MrWANGXUHUI/niu-u1-foc-simulator/niu_u1_foc_simulator/README.md

# 小牛U1 FOC控制器模拟器

基于ESP32-C3的小牛U1电动车FOC电机控制器模拟器，实现损坏FOC控制器的功能替代，并添加霍尔轮速测速和OLED速度显示。

## 功能特性

- **FOC协议模拟** - 完整兼容小牛U1 485总线协议，响应V35中控轮询
- **霍尔轮速测量** - 实时测量轮速，OLED显示车速
- **电量统计** - 精确计算电池能耗(Wh/km)
- **原厂身份模拟** - 应答里带原厂 FOC 的 MU 编号 `MU00001B00000001`、版本串 `U1E02V11U1E02V11`，V35 校验通过
- **OTA 升级** - 开 WiFi 热点，微信小程序通过局域网 HTTP 把新固件直接推进来（不用拆线、不用按 BOOT）
- **BLE 遥测** - 车速/转速/电压/电流 + 总线上的 485 原始帧通过 GATT 推给小程序（看车速不用连 WiFi）
- **电池信息** - 解析总线上 BMS 的应答（电压/电流/电量/温度/单体电压/型号串），经 BLE 推给小程序

> 原计划的「BLE防丢器接近解锁」已放弃（红米手环广播窗口太短抓不稳，且iPhone无法配合），代码中已移除。
> NFC（PN532）无钥匙解锁方案也已于 2026-10-22 移除（驱动代码 / 接线文档 / 库依赖全部删除，I2C 只留板载 OLED）。

## 硬件清单

| 配件 | 型号/规格 | 数量 | 用途 |
|---|---|---|---|
| 主控 | 天问Pro TW002 (ESP32-C3-DevKitC-02) | 1 | 系统控制 |
| 通信 | MAX485模块(自动收发型) | 1 | RS485总线通信 |
| 轮速 | 霍尔传感器(SSR14Y/A3144) | 1 | 轮速测量 |
| 磁钢 | 单个磁铁（1 极） | 1 | 配合霍尔传感器 |
| 电源 | DC-DC降压模块 48V→5V | 1 | 供电 |

> 轮胎：**16x2.50/64-305**，实测转一圈 **1.28 米**（不是标称值）。
> 固件里对应 `MAGNET_COUNT = 1`、`WHEEL_CIRCUMFERENCE_M = 1.28`。

## 协议说明

### 485总线配置
- 波特率: **9600**
- 数据位: **8E1** (8数据位 + 偶校验 + 1停止位)
- 校验和: 从帧头累加到CS前一个字节，取低8位 (sum & 0xFF，**不是** CRC)
- 帧格式: `68 [地址] [地址反码] 68 [功能码] [字节数] [数据+0x33] [校验和] 16`

### 设备地址
| 设备 | 地址 | 备注 |
|---|---|---|
| FOC电机控制器 | 0x20 | 本模拟器 |
| 电池BMS | 0x31 | |
| 仪表 | 0x10 | |
| 中控 V35 ECU | 0x40 | 485 主节点 |

> **应答帧的地址对是「回话设备自己」**：真车抓包里 BMS 回 `31 CE`、仪表回 `10 EF`、FOC 回 `20 DF`。
> 所以本模拟器的应答固定用 `0x20 / 0xDF`（代码里 `REPLY_WITH_ECU_ADDR` 置 1 可改回 `0x40 / 0xBF`）。

### 关键命令
| 命令 | 说明 |
|---|---|
| 0x01 0x03 | 解锁挡位（应答 0x81 + MU 编号 16 字节） |
| 0x02 0x05 0x08 | 查询FOC状态（应答 0x82 + 12 字节，车速在第 9 字节） |
| 0x02 0x05 0x09 | 查询FOC状态（应答 0x82 + 14 字节） |
| 0x01 0x02 / 0x04 | 版本串 / 固件版本 |
| 0x06 | 系统配置（空数据 ACK，与原厂一致） |
| 0x82 | 响应标志(查询响应) |

## 软件架构

```
niu_u1_foc_simulator/
├── platformio.ini
├── partitions.csv            # A/B 双槽 (OTA 用, 每槽 1.75MB)
├── README.md
├── NOTES.md                    # 活文档: 接线表 / 协议 / 已知问题
└── src/
    ├── niu_u1_foc_simulator.ino  # 主程序 (485协议 + 霍尔轮速 + OLED)
    ├── ota_config.h              # OTA 配置 (SSID/密码/IP/端口/版本号)
    ├── ota_server.h              # OTA 服务端 (SoftAP + HTTP /ota/*)
    ├── ble_config.h              # BLE 配置 (设备名 / UUID / 通知周期)
    ├── ble_telemetry.h           # BLE 遥测服务 (车速 + 485 原始帧 + 电池)
    ├── ble_battery_msg.h         # 电池信息的 BLE 打包格式 (纯 C++, 可本机编译测试)
    └── bms_protocol.h            # 电池 BMS 报文解析 (纯 C++, 可本机编译测试)

docs/
├── design_background.md      # 开发笔记(背景、需求、硬件选型)
└── protocol_analysis.md      # 协议分析(帧格式、命令详解)
```

## OTA 升级

ESP32 开 WiFi 热点 `NIU-U1-OTA`（密码 `niu12345`），地址 `http://192.168.4.1:8080`。
手机连上热点后，用微信小程序把固件推进来 —— 接口表和注意事项见 [NOTES.md](NOTES.md) 第 6 节。

```bash
bash ../tools/build_ota.sh        # 编译固件并打包进小程序
bash ../tools/ota_push_test.sh     # 用 curl 模拟小程序，验证固件侧全流程
```

## BLE 遥测

设备同时以 `NIU-U1-OTA` 的名字广播 BLE，GATT 服务 `6e400001-b5a3-f393-e0a9-e50e24dcca9e`
下面挂两个特征：

| 特征 | 内容 |
|---|---|
| `…6e400002-…` | 12 字节遥测（车速×10、转速、电压、电流、协议车速、错误码、解锁标志），200ms 一次通知 |
| `…6e400003-…` | 总线上收到的 485 原始帧，20 字节一节按帧尾 `0x16` 拼回整帧 |

BLE 走的是另一条通道，手机照常联网，不影响 OTA。细节和坑见 [NOTES.md](NOTES.md) 第 6.5 节。

> BLE 协议栈（Bluedroid）占约 700KB flash —— 这是分区表从每槽 1.5MB 扩到 1.75MB 的原因。

## 电池信息（BMS 报文）

485 是半双工总线，V35 问 BMS 的应答我们在旁边也听得见。解析出**总电压 / 电流 / 电量 / 5 个温度 /
单体电压 / 电池型号串**，经 BLE 推给小程序。**我们不冒充 BMS，也不应答任何 BMS 请求。**

15 字节状态帧的布局（大端）：

| 字节 | 含义 | 单位 |
|---|---|---|
| `[0..1]` | 总电压 | 0.1V |
| `[5]` | 电流 | A |
| `[6]` | 电量 | % |
| `[10..14]` | 5 个温度 | °C |

字段布局见 [NOTES.md](NOTES.md) 第 6.6 节，那里有完整的协议说明和验证过程。

## 快速开始

1. 硬件接线 (见下文)
2. 安装ESP32开发板驱动
3. 烧录主程序
4. 磁铁装到轮子上, 霍尔传感器对准磁铁
5. 测试通信

## 接线图

```
ESP32 GPIO7 ──→ MAX485 DI   (485 TX)
ESP32 GPIO4 ──→ MAX485 RO   (485 RX)
ESP32 GPIO5 ──→ OLED SDA    (板载 I2C)
ESP32 GPIO6 ──→ OLED SCL    (板载 I2C)
ESP32 GPIO3 ──→ 霍尔传感器 OUT

MAX485 A/B ──→ 485总线 A/B
霍尔传感器 VCC/GND ──→ 5V/GND
```

> MAX485 用的是**自动收发**小板，板内自带 RC 延时 + 三极管，不暴露 DE/RE 引脚。
> 485 通信参数：**9600 8E1**（不是 115200 8N1）。

> ⚠️ **霍尔传感器必须上拉**：A3144/SSR14Y 是开集电极输出，不上拉会读到噪声脉冲导致轮速乱跳。
> 代码用 `INPUT_PULLUP` 开 ESP32 内部上拉，线长或干扰大时建议外挂 4.7k~10k 上拉电阻。

> ℹ️ **测速用脉冲间隔**：单磁钢 + 计数窗口测不出速度（17 km/h 时 250 ms 窗口只期望 0.9 个脉冲，
> 读数在 0 和 ~24 km/h 之间乱跳）。代码取相邻两次脉冲的间隔（= 转一圈的时间）算 RPM，
> 17 km/h 时分辨率约 0.4%。2 s 内没有新脉冲即判定停转，车速归 0。

> ⚠️ **GPIO9 是 BOOT 键**，不要当普通 GPIO 用；TW002 刷机必须手动按住 BOOT。

## 功耗

| 项目 | 值 |
|---|-----|
| ESP32 + 外设 | ~0.5W |
| 48V24Ah电池续航影响 | 可忽略 |

## 参考资料

### 本项目文档

| 文档 | 地址 | 说明 |
|---|---|---|
| 接线与 GPIO 完整文档（飞书） | https://fcnm1ydb2e5g.feishu.cn/docx/XwprdaKRmoQgUixAL2ncKcq4nzc | 接线图、GPIO 定义、协议帧、异常排查（对外版） |
| 活文档 | [NOTES.md](NOTES.md) | 接线表 / 协议 / 已知问题，以它为准 |
| 开发记录 | [DEVELOPMENT.md](../DEVELOPMENT.md) | 开发方式与历史决策 |
| 协议分析 | [docs/protocol_analysis.md](../docs/protocol_analysis.md) | 帧格式、命令详解 |
| 开发背景 | [docs/design_background.md](../docs/design_background.md) | 需求分析、硬件选型 |

### 开源项目 / 逆向资料

| 来源 | 地址 | 用途 |
|---|---|---|
| xzfn / scooter-repair | https://github.com/xzfn/scooter-repair | 真车 485 抓包日志 + 可用的 V35 ECU 替代固件。本模拟器的应答帧格式（MU 编号 `MU00001B00000001`、版本串 `U1E02V11U1E02V11`、12/14 字节状态帧字段布局）全部对齐它；含 FOC 解锁 CRC16（poly 0x7085）算法 |
| Jonesyme / niu-bms-readout | https://github.com/Jonesyme/niu-bms-readout | Python 实现的 BMS 上位机协议 |
| B 站 cv39475428 | https://www.bilibili.com/read/cv39475428 | 《小牛 V35 中控专用协议总结》—— 帧格式、校验和、示例帧 |
| 小牛电池协议逆向 | https://zhuanlan.zhihu.com/p/419857440 | 电池侧协议 |
| SMZDM 开源救活老小牛 | https://post.smzdm.com/p/a3mdqg4r/ | 整体方案参考 |

## License

MIT
