MrWANGXUHUI/niu-u1-foc-simulator/DEVELOPMENT.md

# 小牛U1 FOC模拟器 — 开发记录

## 项目概述
基于 ESP32-C3 开发的小牛 U1 电动车 FOC 控制器模拟器，替代已损坏的原车 FOC 控制器，
响应 V35 中控的 485 轮询，让整车（中控 / 仪表 / 电池）认为 FOC 工作正常。

使用 PlatformIO + Arduino 框架开发。

> 当前接线表、协议细节、已知问题见 **`niu_u1_foc_simulator/NOTES.md`**（活文档，以它为准）。
> 本文只记录开发方式和历史决策。

---

## 硬件配置

| 组件 | 型号/参数 |
|---|---|
| 主控 | 天问 Pro TW002 (ESP32-C3-DevKitC-02, **4MB Flash**) |
| 显示 | 0.96寸 OLED (SSD1306, 128×64, I2C GPIO5/6, 板载) |
| **485 通信** | **Serial1 (9600 8E1, GPIO7=TX / GPIO4=RX)** 连接 V35 ECU (地址 0x40) |
| **调试日志** | **UART0 (Serial, 115200 8N1, 经板载 CH340)** — 仅 ASCII 文本，独立通道 |
| 轮速 | 霍尔传感器 A3144/SSR14Y (GPIO3, 1 磁钢) + 轮胎 16x2.50/64-305 (周长 1.28m) |

> **串口完全隔离：** 代码里所有 `Serial.printf` 走 UART0，所有 `Serial1.*` 只用于 485 帧收发，互不干扰。
>
> ⚠️ **调试口是 UART0，不是原生 USB CDC。** `platformio.ini` 里的 `-DCDC_ON_BOOT=1` 对 ESP32-C3 **无效** ——
> core 2.0.17 只认 `ARDUINO_USB_CDC_ON_BOOT`（默认 0），认错了宏 `Serial` 就还是 UART0。
> 现状是好的：TW002 板载 CH340 正好接在 UART0（GPIO20/21）上，插 USB 就能看到日志，
> 而且 **UART0 的 TX 不会像原生 USB 那样在"没人读"时长时间阻塞**。
> 想改成原生 USB 得把宏换成 `-DARDUINO_USB_CDC_ON_BOOT=1`，届时 `Serial.flush()` 的阻塞风险要重新评估。
>
> **Serial1 引脚为何不选 GPIO20/21：** ESP-IDF 启动日志系统会把 UART0 初始化在 GPIO20/21，
> Serial1 (UART1) 再去抢同一对引脚会导致 driver 死锁。
> GPIO2/8/9 是 strapping pin，GPIO11-17/18/19/20/21 分别被 flash / USB / UART0 占用，
> 所以 485 只用安全引脚 **GPIO7 (TX→MAX485 DI)** 和 **GPIO4 (RX←MAX485 RO)**。

### 引脚选型速查
ESP32-C3 上**完全安全**的 GPIO 只有 **3、4、5、6、7、10** 六个。
本项目 5 个外设引脚全部落在安全区，没有一个碰到 strapping / flash / USB。

---

## 功能模块

### 1. 485 帧解析
- 帧格式：`68 [地址对] 68 [功能码] [字节数] [数据+0x33] [校验和] 16`
- 校验和 = 从帧头累加到 CS 前一字节，取低 8 位（**sum & 0xFF，不是 CRC**）
- 字节 1+2 永远是"目的设备对"，不是 Modbus 站号；协议里没有发送方地址字段

### 2. V35 ECU 协议握手
整车 485 主节点是 **V35 ECU（地址 0x40）**，不是仪表。模拟器作为从节点 **0x20** 响应：

| FUNC | 含义 | 模拟器响应 |
|---|---|---|
| `0x01` | 控制命令 | 子命令 `0x02`→版本串 `U1E02V11U1E02V11`、`0x03`→MU 编号 `MU00001B00000001`（兼解锁）、`0x04`→`0x11` |
| `0x02` | 状态查询 | `05 08`→12 字节状态帧（车速协议值在第 9 字节）；`05 09`→14 字节 |
| `0x04` | 写数据 | ACK `0xCD` |
| `0x05` | 设置参数 | ACK `0xCE` |
| `0x06` | 系统配置（主/从模式） | 空数据 ACK（原厂即如此） |

> **应答帧地址对是「回话设备自己」**：真车抓包里 BMS 回 `31 CE`、仪表回 `10 EF`、FOC 回 `20 DF`，
> 所以本模拟器应答固定用 `0x20 / 0xDF`（`REPLY_WITH_ECU_ADDR` 置 1 可改回 `0x40 / 0xBF`）。

所有 V35 命令都通过 `Serial.printf("[485←] ...")` / `"[485→] ..."` 输出，方便抓包调试。

### 3. 霍尔轮速测量
- GPIO3，`INPUT_PULLUP` + 下降沿中断
- **霍尔必须上拉**：A3144/SSR14Y 是开集电极输出，不上拉读到的是噪声脉冲，轮速会乱跳
- ISR 加 1ms 消抖（1 磁钢在 30km/h 下脉冲间隔约 153ms，不会漏计）
- **测速用脉冲间隔**（单磁钢下计数窗口会乱跳）：`RPM = 60/(间隔秒数×磁钢数)`，17 km/h 时分辨率约 0.4%
- **当前是霍尔实测模式**：`USE_HALL_SPEED 1`；2 s 没有新脉冲就判停转，车速归 0 并置驻车标志

### 4. OLED 显示
只显示速度：大字 `km/h` + 底部 RPM / 错误码，每 200ms 刷新。
OTA 进行中临时切成 OTA 画面（SSID + IP + 进度条），完成后恢复。

### 5. OTA 升级（2026-10-27 加）
ESP32 开 SoftAP，手机连上去，微信小程序通过局域网 HTTP 把新固件直接推进来。
详细接口和约束见 `niu_u1_foc_simulator/NOTES.md` 第 6 节，这里只记两个决策：

- **为什么是 WiFi 局域网直传**：车停楼下、车上没网，人在 10 楼。BLE 写 320KB 在 iOS 上
  要 20 字节一片、慢到十几分钟以上且静默失败；4G 模块又太贵。而微信小程序的**局域网例外**
  允许 `${IP}:${PORT}` 形式的 http 请求不做安全域校验 —— 于是不用备案域名、不用证书、
  不用云开发，ESP32 也不需要公网出口。
- **为什么固件要 base64**：Arduino WebServer 把 POST body 存成 `String(plainBuf)`，
  按 C 字符串处理，**遇 0x00 就截断**，原始二进制必坏。base64 是纯 ASCII 才安全。
  core 的 `base64` 只有 encode 没有 decode，所以解码器是自己写的。

> 2026-10-30 起热点**默认关**，由蓝牙命令临时打开（见下面 §7）。

### 6. BLE 遥测（2026-10-28 加）
OTA 走 WiFi 热点，手机一连热点就断网；看车速不需要断网，所以另开一条 BLE 通道：
GATT 服务把车速/转速/电压/电流和 485 原始帧推给小程序，手机照常上网。

- Arduino-ESP32 2.0.17 自带的 `BLE` 库在 C3 上能编能跑，PlatformIO 不用额外配置
- **代价是 flash**：Bluedroid 协议栈一个人占 ~700KB，直接把分区表撑爆了（见下面分区方案）
- **坑**：断连后不能在自己的回调里重启广播（会被静默丢掉，设备就再也扫不到了），
  必须延后到主循环
- **遥测载荷 20 字节**（前 12 字节是旧格式，老小程序照样能解）：车速/转速/电压/电流 +
  485 协议车速值，外加 5 个诊断字段（V35 轮询次数、应答次数、霍尔脉冲数、校验和错帧数、
  脉冲间隔）。骑车时看小程序就能分清「总线没通」还是「霍尔没信号」

### 7. 蓝牙优先架构（2026-10-30 加，v1.4.0）
**平时只用蓝牙，WiFi 只在 OTA 那几分钟开一下。** ✅ iPhone 实测已连上

原来的设计是开机就开 SoftAP，问题是手机一连热点就断网、SoftAP 白耗电、
两边射频同时用还会影响 BLE 广播节奏。改成：

- 固件开机**不开热点**（`ota_config.h` 的 `OTA_AP_DEFAULT_OFF 1`），只注册 HTTP 路由
- 小程序要升级时，通过**蓝牙命令特征**（`6e400005-…`）写一个字节 `0x57` 把热点临时打开
- 推完固件板子重启，自然回到默认关的状态

**关键决策与踩过的坑**（细节见 `niu_u1_foc_simulator/NOTES.md` §6.7 / §7.3）：

1. **设备名必须放主广播包**。库默认把名字塞扫描回应，而 iPhone 后台小程序是**被动扫描**，
   收不到扫描回应 → 看到「没名字的设备」被按名字前缀过滤掉。Linux 用主动扫描，
   台架上一直看得到，所以**测不出来**。（这本身是个该改的问题，但**不是**扫不到的根因，
   根因见下面第 9 条。）
2. **广播间隔显式设 100~150ms**，别用库的默认 20~40ms（后者在 WiFi 共存时不够稳）。
3. **BLE 命令要用带 param 的 `onWrite` 重载**——废弃版里 `getValue()` 拿不到刚写的字节；
   命令字节取**最后一个**（有些工具写的是大端 2 字节）。
4. **关热点不能用 `WiFi.mode(WIFI_OFF)`**，那会把整个 WiFi 协议栈拆掉；
   改用 `esp_wifi_set_mode(WIFI_MODE_NULL)`，协议栈留着随时能开回来。
5. **重开热点时 HTTP server 必须重新绑定**（`WebServer::begin()` 内部先 close 再监听）。
6. **`server.begin()` 必须等 WiFi 栈起来才能调**——WiFi 从没初始化过就开监听会
   `tcpip_send_msg_wait_sem: Invalid mbox` 反复 panic。
7. **微信小程序在 iOS 上不能传 `services: []`**——iOS 实现里空数组被当成「过滤条件存在」，
   只上报广播里带服务 UUID 的设备。我们主广播包只有 Flags + 名字（名字必须放主广播包），
   正好被过滤掉。改成**不传 services**，扫到全部再在 JS 里按名字筛。
8. **固件要定期重启广播**（没连手机时每 15 秒一次）。`advertising->start()` 有可能撞上
   GAP 状态机没准备好而被静默丢掉——代码却以为成功了，于是设备进入「活着、485 正常、
   但 BLE 再也不广播」的状态，车上没法自查。
9. **手机端 API 要做版本兼容** ⭐ —— 这是踩过最大的坑：`wx.onBluetoothDevicesFound`
   是**基础库 2.11.0 才有**的，用户手机上只有单数的 `wx.onBluetoothDeviceFound`，
   扫描回调压根没注册上 → 表现为「怎么改固件的广播包都扫不到设备」。
   现在 `discover()` 三路兜底（新版事件 / 旧版单数事件 / `getBluetoothDevices` 轮询），
   并且点连接时先跑 `ble.missingApis()` 自检、缺什么直接列出来。
   `project.config.json` 的 `libVersion` 也从 3.0.0 提到 3.7.12。

**这一轮的教训（比技术细节更重要）**：查「手机端功能不工作」时，
**先确认手机端那段代码真的跑到了**，再去查设备/固件侧。
前面三轮都在改固件的广播包（名字放主广播包、加 UUID、放宽广播间隔），
还改了架构（WiFi 默认关）—— 那些改动本身都对、该做，
但**真正卡住的是手机端一行 API**，方向从一开始就偏了。
让用户贴**原始报错原文**（「wx.onBluetoothDevicesFound is not a function」），
比让他描述「功能不工作」有用一百倍。

**一个反面教训**：查 BLE 广播节奏**不能只看 btmon 的计数**——它抓的是控制器重复过滤后的上报，
会造出「16 秒才广播一次」的假象。真实数据要用 `hcitool lescan --duplicates`（需 root，
且要先停 bluetoothd，否则适配器被占用、扫不到任何东西）。
实测 WiFi 关/开/开+有客户端，广播速率都是 ~8~10 个/秒，**不存在共存限流**。

### 8. 电池 BMS 报文解析（2026-10-28 加）

485 是半双工总线，所有节点都能听到别人说的话。V35 问 BMS「电量多少」时，
BMS 的应答我们在旁边也收得到 —— 于是把它解析出来推给小程序。

**为什么不冒充 BMS**：冒充的话 V35 会把我们当电池，电池信息就成了我们自己编的；
只听不答，拿到的是**真车电池**的数据。

- 解析代码在 `src/bms_protocol.h`，**纯 C++ 不依赖 Arduino**，所以能在 PC 上编译跑测试
- 打包代码在 `src/ble_battery_msg.h`，同样纯 C++ —— 固件和小程序两边的字节布局
  可以用一个本机测试脚本对起来（固件打包 → 小程序解析，值必须一致）
- 15 字节状态帧的布局来自 xzfn/scooter-repair 的分析文档，但**没有直接照抄**：
  用该仓库 7 个真车抓包日志（2041 帧 BMS 报文）逐字段核对过，解析成功率 100%、
  校验和 0 错，而且状态帧的总电压跟单体电压求和一致 —— 这才敢用

**顺带修的分帧 bug**：原来靠 `0x16` 找帧尾，但数据区里也可能出现 `0x16`
（明文 `0xE3` + `0x33` 混淆后正好是 `0x16`），会把一帧劈成两半。
现在按长度字节定帧：整帧 = `6 + len + 2`。

---

## 9. 小程序界面重构（2026-11-02 加）

车辆页实拍（2026-11-10，固件 1.5.3）：

小程序车辆页

*从上到下：* 连接条 → 大字车速 → 转速/电压/电流/解锁状态 → 电池区（电量 %、总电压/电流、
温度、13 串单体电压柱状图）→ BMS 应答诊断（总线 666 帧 · 解析成功 666，校验错 0）
→ 电量与总电压两条趋势曲线。

原来一个小程序里塞了「遥测看板」+「固件升级」两件事，页面逻辑绕：想升级得先翻到
页面底部找输入框，想看车速得先跳过一堆升级控件。拆成两个 tab：

| tab | 页面 | 干什么 |
|---|---|---|
| 车辆（默认） | `pages/vehicle/vehicle` | 连蓝牙 → 大字车速 → 转速/电压/电流/错误码 → 电池 → 折叠的诊断和 485 原始帧 |
| 升级 | `pages/upgrade/upgrade` | 三步引导：①蓝牙开热点 → ②手机连热点 → ③传固件 |

**核心改动：蓝牙连接提到全局单例**（`miniprogram/utils/bleLink.js`）。

两个页面都要蓝牙。连接状态如果只存在页面里，两个页面各连一次、互相踢掉，
用户完全搞不清发生了什么。现在 `bleLink` 管连接，页面只订阅：

```js
const unsubState = bleLink.onState((s) => { ... })   // 连接状态
const unsubData  = bleLink.onData((kind, v) => { ... }) // 遥测/帧/电池/命令
```

顺带修掉一个老 bug：通知回调（`wx.onBLECharacteristicValueChange`）原来在页面
`onLoad` 里注册但 `onUnload` 没注销 —— 页面来回进出就会重复注册，同一批数据被处理多次。
现在统一在 `bleLink` 里注册一次，按特征 UUID 分发给订阅者。

**升级页为什么是三步**：OTA 里混着两类动作 —— 「设备开热点」是设备自己的动作，
「手机连热点」是用户必须手动做的动作。混在一个按钮里用户不知道该干嘛。
拆成三步后每一步都有明确的完成标志：

- ① 的完成标志是**蓝牙命令写成功**，不是 HTTP 探测 —— 手机这时还没连热点，没有
  `192.168.4.x` 网段，HTTP 必然通不了，分不清是「热点没开」还是「手机没连热点」。
- ② 用 HTTP 探测 `/ota/info` 判断手机连上热点没有（小程序读不到手机的 WiFi 状态，只能探）。
- ③ 传完固件，**成功标志是 `ota.end()` 返回那一刻**，不是之后的探测 ——
  设备重启后 WiFi 默认关，探测必然失败。

**升级完成后设备重启、热点自动关**，所以页面把 `info` 清掉（按钮自动变灰），
并提示「去车辆页确认版本」—— 蓝牙不受影响，车辆页能问到新版本号。

固件侧配套加了 `'V'` 命令（`0x56`）：小程序写一个字节，固件回 `['V', "1.4.2"]`。
平时 WiFi 是关的，问不到 `/ota/info`，只有蓝牙这条路能问版本。

**改页面路径要留跳板页**（2026-11-02 踩的坑）：`pages/telemetry` 改名成 `pages/vehicle`
之后，小程序默认打开报「该页面不存在」，但点左上角「首页」正常。
因为小程序可以带着一个页面路径被打开，而这个路径可能记在公众平台的「小程序主页」、
老的小程序码、历史分享链接里 —— 全指着改名前的路径。

**首页能进、默认进不去 = 默认路径是陈旧的。**
修法是旧路径留着同名空页，进来就 `wx.switchTab` 到新页面
（tabBar 页面只能用 `switchTab` 跳，`redirectTo` 跳不过去）。

---

## 10. 一个把自己绕进去的 bug：printf 参数错位（2026-11-02）

**症状**：`GET /ota/info` 一发，板子立刻 Guru Meditation 重启。OTA 第一步就断。

```
Guru Meditation Error: Core 0 panic'ed (Load access fault). Exception was unhandled.
MCAUSE : 0x00000005   MTVAL : 0x00000001
```

`MTVAL = 0x1` 是关键：**有个 `%s` 吃到了一个整数 `1`，把它当指针解引用了**。

根因是 `/ota/info` 的 JSON 用 `snprintf` 拼，格式串末尾加了 `"apOn":%d`，
但新参数 `(int)apOn_` 被**插在了参数列表第 5 位**而不是最后，于是整体错位一格：

| 位置 | 格式串要的 | 实际传进去的 |
|---|---|---|
| 5 | `%s` (state) | `(int)apOn_` = **1** ← 当成 `char*` 去读地址 `0x1` |
| 6 | `%u` (progress) | `stateName()`（`char*`） |

`snprintf` 是变参函数，**类型对不上编译器不报错**，只能运行时炸。

**查这个 bug 走的弯路（值得记下来）**：panic 栈底有一堆 `mbedtls_sha256` /
`esp_sha_dma` / `gdma_connect` 的帧，看着像「WiFi 加密硬件跟 SHA 抢 GDMA 通道」。
**那是假线索** —— FreeRTOS 会复用任务栈，那几帧是 WiFi 任务之前留下的旧数据。
判断依据：把 `ESP.getSketchSize()`（它内部确实会 `esp_image_verify()` 算 SHA）去掉之后，
**崩溃地址一点没变**（`MEPC` 还是 `0x40058e94`）。

有效的二分办法：加几个只拼一部分参数的临时路由逐个测 —— 结果每个参数单独拼都不崩，
全部拼一起才崩，才反应过来是错位。

**怎么防**：参数顺序跟格式串一一对应，每个参数后面加注释标明对应哪个占位符。
另外顺手把 `ESP.getSketchSize()` 换成直接查分区表 —— 那个函数每次调用都要把
1.5MB 的镜像 SHA256 重算一遍，又慢又跟 WiFi 加密抢硬件通道。

---

## 11. 上车待办 (2026-11-04)

开车实测发现两个新问题, **排查步骤写在 `niu_u1_foc_simulator/NOTES.md` §7.4** (那里是活文档, 以它为准),
这里只记一句话摘要, 免得以后翻不到。

| # | 问题 | 一句话 | 详情 |
|---|---|---|---|
| A | 车速大 40 倍 | 真实 20 km/h, 小程序显示 800~1000 km/h。协议换算那条路已排除 (协议值封顶 127 = 60.9 km/h), 错在**内部 kmh 计算**: 固件以为脉冲每 ~6ms 来一个 (应该是 ~230ms)。**已定位**: ISR 消抖只有 1ms, 传感器毛刺穿过去把真间隔劈成两半, 中位数被污染 → 固件 1.4.4 加了 25ms 物理闸门, 待上车复测 | NOTES §7.4 待办 A |
| B | 中控五分钟后断电 | 先分清是"中控自己断"还是"中控切断了 FOC 的电"。怀疑: ① ECU 要的周期帧我们没回 ② `0x38`/`0x3C` 查询我们静默不回 ③ 解锁的 CRC16 token 没实现 | NOTES §7.4 待办 B |

---

## 12. 蓝牙通知搬进独立任务 + 485 总线日志（2026-11-04 加，固件 1.5.0）

这一节是同一件事的两面：**「app 连上蓝牙后 BMS 没数据」这个现象的定位和修法**，
以及为了定位它而做的**485 总线日志**（顺手变成了一个长期好用的工具）。

### 12.1 现象与推断

症状：手机连上蓝牙以后，小程序上车速正常、485 原始帧也有，但**电池面板一直是空的**。

两条链路（固件 → 小程序）挨个查：

| 链路 | 代码路径 | 结论 |
|---|---|---|
| BMS 应答解析 | `bms_protocol.h` 的 `bmsParseFrame` | 解析逻辑本身没问题（用 2041 帧真车抓包验过，100% 成功） |
| BLE 电池通知 | `ble_telemetry.h` 的 `sendBattery()` | 打包格式跟小程序端对得上（`tools/test_miniprogram_ble.js` 验） |

那就只剩**时机**问题。关键的一条硬约束在 NOTES §3：

> V35 单次轮询的超时只有 **~20ms**（抓包量出来的），超了 ECU 就置错误码 190、车速显示 0。

而 1.4.4 的 `bleTelemetry.handle()` 是**在主循环里直接发 notify 的**，主循环同时也是
485 应答的路径。一次通知突发（遥测 1 包 + 485 帧 1~4 包 + 电池状态 1 包 + 单体 2 包
+ 型号 1 包，最多 8~9 包）就把应答路径堵住了 —— 手机一连上才开始有这些包，
**平时不连蓝牙的时候反而没有这个压力**，这跟"连上才出问题"的现象对得上。

更麻烦的是包的顺序：遥测是每次突发里的**第一个**（总是发得出去 → 车速正常），
电池状态是**最后一个**（最先被丢 → 电池没数据）。现象跟机制完全对得上。

### 12.2 修法：通知全部交给 BLE 任务

跟 OLED 任务一个思路（NOTES §5.0）—— **慢活挪出主循环**：

- 主循环现在只往快照里塞数据（一次几十字节的 memcpy，用互斥量保护），立刻返回
- 通知（遥测/电池/485 帧/日志）全部在独立的 `ble` 任务里发（栈 4KB，优先级 1）
- 顺手把通知量压下来：电池状态 5Hz → 2Hz；单体电压要变化 ≥3mV 才推（以前 1~2mV
  的抖动也推，等于每秒多发 2 个包）；485 帧只推"最新一帧"

命令（开热点/问版本/取日志）的执行**仍然留在主循环** —— WiFi 开关必须在主循环做
（BLE 任务里动 WiFi 会跟共存调度打架，NOTES §6.5 有记录）。

### 12.3 485 总线日志

手机上的 485 帧是「每 200ms 推最后一帧」的采样，总线实际约 30 帧/秒 ——
**采样只剩 5 帧/秒，八成的帧看不到**，拿这个离线分析是白搭
（"某帧没来 / 某帧被撞坏"这种问题，恰恰只能靠日志找）。

所以日志记在**板子上**（总线上唯一的全知视角，每个字节它都收得到）：

| 环节 | 实现 |
|---|---|
| 记录 | `src/bus_log.h`：256 条记录的环形缓冲，每条 = 时间戳(u32) + 方向 + 帧字节。RX 和 TX 都记 —— 只有同时看到「V35 的问」和「我们回的答」跟时间戳，才算得出应答延迟 |
| 拉取 | 手机写 `'L'` 命令（带参数 = 起始字节偏移），设备把日志转成文本分块推回来。拉取期间**冻结**日志（不然传一半前面的数据被新帧顶掉，日志就废了） |
| 包格式 | `[0]'L' [1]flags(bit0=最后一块) [2..5]偏移 [6..9]总长 [10..]文本`。带偏移是故意的：蓝牙通知可能丢包，有偏移手机才能发现缺口并让设备重发 |
| 保存 | 小程序写文件到沙箱 → `wx.shareFileMessage` 发进微信（文件传输助手）→ 电脑上保存。老微信没这个 API 就退回复制文本到剪贴板 |
| 分析 | `tools/analyze_485_log.py`：概览 / 应答延迟 / BMS 解析 / 异常统计 |

**注意**：环形缓冲只存最近 256 帧（RAM 只有 ~110KB 空闲，16KB 已经是能给的极限），
按总线实际速率约 8~9 秒。车上的问题基本都是「刚才那一会儿不对」，够用；
要更长的历史得加分区写 flash（**不行**：擦扇区会堵住 CPU 100~300ms，当场把 485 时序搞坏）。

**自测**：`bash tools/run_tests.sh` —— 不用板子不用车，几秒钟跑完，
包括**跨语言还原**（设备侧生成的包 → 小程序端解析 → 跟原文逐字节一致）。

### 12.4 BMS 诊断计数

固件新增 `BmsDiag`，随电池特征的第 4 种消息推给小程序，小程序上直接显示：

```
BMS 应答     总线 42 帧 · 解析成功 40
解析错误     校验错 1 · 长度错 1 · 未知长度 0
最近一次     距上次 BMS 应答 0.3 秒
```

这三种情况一眼能分清：

| 现象 | 说明 |
|---|---|
| 总线 0 帧 | BMS 压根没在总线上回话（电池侧/接线/它不轮询） |
| 总线有帧、成功 0 | 帧收到了但被干扰或被撞坏（校验和错） |
| 成功 > 0 但小程序还是没数据 | 固件这边完全正常，问题在蓝牙这一段 |

> 统计时注意区分：地址对 `31 CE` 的帧有**两种** —— V35 问 BMS 的请求（功能码 0x02）
> 和 BMS 回 V35 的应答（0x82）。只有后者才是"BMS 回话了"，混在一起数会虚高一倍。

### 12.5 GATT 服务的 handle 不够，第 5 个特征静默失灵（1.5.1 修）

第一次做 485 日志时，"保存日志"按钮**永远是"导出中"，一次都没成功过**。
查下来的根因不在日志逻辑，在 BLE 服务本身：

Arduino BLE 里**每个特征占 3 个 handle**（特征声明 + 值 + CCCD 描述符），
服务默认只给 15 个（扣掉服务自己的 1 个 = 14 个可用）。
原来 4 个特征占 12 个刚好够用；加到第 5 个（日志特征）就要第 15 个 → **越界**，
`esp_ble_gatts_add_char` 失败，特征**根本没建出来**。

症状特别坑：

- 前 4 个特征一切正常（车速、电池都对）→ 容易怀疑"是不是日志协议写错了"
- 手机订阅不到日志特征 → `ble.subscribe()` 抛异常，被 `try/catch` 吞了 → 连日志都没有
- 板子往一个 handle 都没拿到的特征上 `notify()` → 什么也发不出去
- 手机那边就一直等 → "导出中"

修法：`server->createService(BLE_SERVICE_UUID, 25)`（显式给够 handle）。
**教训**：加 BLE 特征的时候，handle 数量要自己算，别用库的默认值。

顺带修的两处：

- **传输超时误杀**：原来"手机多久没来要下一包"（20 秒）就掐断传输，但这个计时器
  **在发包时不刷新** —— 包小的时候（对端 MTU 小，一包只带十来个字节）整份日志要传
  几十秒，中途就被自己掐了。改成每发一包续一次命。
- **包大小**：手机把自己协商出来的 MTU 一起告诉设备（`wx.getBLEMTU`），
  设备取"自己看到的"和"手机报的"里**小**的那个来决定一个包带多少字节。
  报大了会被蓝牙协议栈**截断**发出去，手机收到半个包 → 偏移对不上 → 一直要求重发
  → 永远拉不完。

小程序侧还加了两道保险：固件里没有日志特征时（`hasLog` 为 false）按钮直接禁用并
说明原因；拉取 12 秒没有任何动静就报错并说明收到多少字节，不再无限转圈。

### 12.5b 拉完日志后蓝牙通知再也不发了（1.5.2 修）

用户实测反馈：拉完 485 日志之后，小程序的**速度固定在 19.6 km/h 不动**、电池也没数据。

抓下来的日志（`docs/niu485-20261106-090017.log`）把范围缩得很小：

- 固件**活着**：日志里 57 次 V35 轮询、57 次应答，延迟 1~16ms，全都赶得上 20ms 的预算
- 但固件报的车速是**协议值 5（2.4 km/h）**，而 App 显示 19.6（协议值 41）→ **App 上的数是陈旧的**

也就是说：固件在正常应答 485（主循环好好的），**只是 BLE 通知没发出去**。

根因是 1.5.1 我自己写的：

```cpp
if (pumpLog()) return true;      // ← 日志在传就直接 return, 后面的通知全不发了
```

而 `pumpLog()` 在"最后一块已经发完"的状态下**永远返回 true** —— 于是拉完日志之后，
BLE 任务永远卡在"传输中"，遥测/电池再也不发了。

修法（三层保险）：

1. **日志传输不再挡正常通知** —— `pumpLog()` 的返回值只用来决定"要不要发 485 帧"
   （拉日志期间那 5 包/秒可以省掉，日志本身就是 485 数据），**遥测和电池照发**
2. **拉完自动收摊** —— 最后一块发出去 3 秒后自动解冻日志、恢复记录（`BLE_LOG_SETTLE_MS`），
   不再无限期占着
3. **App 的"拉完了"命令只是加速手段**，不是唯一保障

> **教训**：任何"临时进入某个状态"的逻辑，都不能把**常态功能**（通知）也一起停掉 ——
> 一旦那个状态退不出去（命令丢了、异常路径没走到），表现就是"某个功能莫名其妙死了"，
> 而且从外面看完全不像日志的问题。

### 12.5c 这台车的 BMS 回 55 字节（1.5.2 修，电量一直空着的真正原因）

同一次抓包发现的第二件事：**BMS 有回话，但我们一帧都没认出来**。

| | V35 问 BMS | BMS 回 |
|---|---|---|
| 文档记的那台车 | `2d 0f` | 15 字节（状态） |
| **这台车** | **`2d 37`** | **55 字节 = 15 字节状态 + 40 字节单体电压** |

我们原来只认 15/40/43 字节 → **整帧被丢掉** → 小程序上电量一直是空的
（而"电池没数据"这个现象跟 §12.1 的蓝牙通知问题叠在一起，更难查）。

55 字节帧的前 15 字节跟文档记的状态帧**布局完全一致**（电压/电流/电量/温度四个位置
都能对上），后 40 字节也跟文档记的单体电压帧一致（大端 u16 mV，到第一个 0 为止）——
就是两段拼在一帧里。加一个 `BMS_FULL_LEN = 55` 的分支就行。

实测解出来的值：**46.1V / 63% / 13 串 3.47~3.55V（求和 45.44V）/ 温度 4~7°C** ✓

**电流单位**：原始字节 76~159，按文档记的"A"算等于 7.3kW（踏板车没那么大），
按 **0.1A 一档**算（7.6~15.9A）才合理 → 代码里用 `BMS_CURRENT_SCALE` 控制。

### 12.5d App 侧：停滞检测 + 日志对账（1.5.3 加小程序）

1.5.2 修完"日志传输挡住通知"之后，用户反馈**速度还是有概率冻结**。这次的思路是
**别猜，把两边的值放进同一份日志对账**：

- **App 侧最后收到的遥测**写进导出日志的文件头：
  `# APP 车速 19.6 km/h | 协议车速 41 | 收到于 ...`
- **固件侧解析出来的车速**本来就在日志正文里（我们回给 V35 的帧里那个车速字节）
- `tools/analyze_485_log.py` 多一节「车速对账」，两边不一致就直接点破：

  ```
  固件解析值: 57 帧, 协议车速 5 ~ 5 (2.4 ~ 2.4 km/h)
  App 侧最后收到: 19.6 km/h (协议车速 41) —— **跟固件对不上 → App 侧是陈旧数据, 蓝牙通知链断了**
    差 17.2 km/h. 固件这边明明在变, App 这边没更新 → 不是测速的问题, 是通知没送到
  ```

  这一条把"是测速错了还是数据没送到"变成了看一眼就有的答案。

- **App 侧停滞检测**：连着但 4 秒没收到遥测 → 顶部弹"数据停滞 —— 蓝牙通知断了"
  的提示条 + 一个「重新连接」按钮。**不再默默显示最后一个值装没事**
  （之前速度冻在 19.6，用户完全看不出是 App 断了还是车真的没动）。
  iOS 把小程序切后台/锁屏时会挂起通知投递，这是最常见的触发条件。

### 12.5e 单体柱状图的标签宽度（1.5.3 修小程序）

用户反馈"电压更低的串，柱子却更高"。查下来是**标签排版宽度溢出**：

13 个 "3.618" 挤在 ~20pt 宽的柱子里（窄屏 iPhone SE 320pt 宽），文字的**排版宽度**
超出柱子 → 压到隔壁柱子上 → 看着就"对不上"。

⚠️ `transform: scale(0.85)` 只缩**渲染**不缩**排版**，救不了这个（这也是原来看着
"有点挤但没坏"的原因 —— 在宽屏上刚好没溢出，窄屏就炸了）。

修法：字号 16rpx → 12rpx（5 字 ≈ 18pt，320pt 窄屏也放得下）+ 点柱子弹详情
（第几串、多少伏、相对平均偏差多少 mV）+ 头部补一行"最大差 XX mV"并说明
**柱高 = 相对最低串的偏差**（这个图本来就是放大看的，不标出来会误导）。

自测里加了"柱高与电压单调对应"和"标签排版宽度放得下（按 320pt 窄屏算）"两条断言。

### 12.6 测速的自适应毛刺闸门（1.5.1 加）

用户反馈："速度有时候会跳变，但匀速骑一会就准了，车最高 40km/h"。

第一版毛刺闸门是**绝对阈值 25ms**（1.4.4 加的，挡住 6ms 那种振铃，车速离谱 40 倍就是它）。
但骑车时真实的间隔是几百毫秒（40km/h → 115ms），**50~60ms 的振铃照样穿得过去** →
混进历史 → 中位数被污染 → 车速跳来跳去，匀速骑一会（中位数收敛）才准。

加第二道闸门：**拿最近一次可信的间隔当参照**，比它短 40% 以上的脉冲判为毛刺。
物理上不可能是真加速（一个间隔里速度要翻一倍，踏板车做不到）；加速时参照量自己会
跟着变小，不会误杀。

- ISR 里用"最近可信间隔"（`last_good_interval_us`，主循环更新）→ 毛刺在**进时间戳之前**
  就被挡掉，历史不会被污染
- 主循环里再用"最近中位数"挡一次（双保险）

小程序诊断区加了"**测速波动 (5 秒)**"：最近 5 秒车速的最大最小差。
骑车时一眼看出稳不稳 —— 数值大就是传感器在抖。

**✅ 2026-11-05 上车验证：跳变没了。** 用户确认 1.5.1 这版有效 —— 说明跳的是**往上**
（多出来的振铃脉冲），自适应闸门正好治这个；也就没必要加"间隔比中位数大很多就丢弃"
那条规则了（它在急刹时容易误杀）。

> **已知限制**：主循环 100ms 才处理一次脉冲间隔，所以车速超过 ~90km/h 时
> 一个周期里可能来两个脉冲，只算了一个 → 速度会偏小。车最高 40km/h（115ms/脉冲），
> 不受影响。要支持更高速度得让 ISR 自己算间隔并塞进环形队列。

### 12.7 电池趋势图

车辆页电池区加了一张 canvas 图（`miniprogram/utils/chart.js`）：
上块 电量 %（固定 0~100），下块 总电压 V（自动缩放）。

画图的几条规矩（照 dataviz 那套方法走）：

- **不搞双 Y 轴** —— 电量是 %、电压是 V，量纲不同，硬塞一张图两条线的交叉点毫无意义，
  所以拆成上下两块小图（small multiples），各自一个纵轴
- 每个面板只有一条线 → 不要图例，面板标题就是它的名字
- 线宽 2px，网格和坐标轴弱化到背景里
- 只标**最新值**，不是每个点都标数字
- 文字用中性色，不用线的颜色
- 配色用校验过的分类色（深色模式：电量 `#3987e5`，电压 `#199e70`）

数据是每 5 秒收一个点、最多 120 个（10 分钟），画在 canvas 上（老 API，
所有基础库版本都能用 —— 用户的微信基础库比较老，不能用新的 canvas 2D 接口）。

---

## 已移除的功能

### BLE 防丢器接近解锁（2026-10-20 移除）
原设想用 BLE 防丢器 RSSI 做无钥匙解锁，已放弃。

**放弃原因**：红米 Watch 3 广播窗口极短（1-2 秒）抓不稳；iPhone 不主动广播 BLE、也无法自建 iOS App；
依赖的 WiFi AP + Web 扫描页面（`web_config.h` / `web_pages.h` / `web_server.h`）一并删除。

**替代**：V35 中控的 `0x01` unlock 命令直接应答成功，挡位解锁由中控自己判断。

> 2026-10-22：NFC（PN532）方案也一并移除 —— 驱动代码、接线文档、库依赖全部删掉，I2C 只留板载 OLED。

### WiFi AP + Web 扫描页面（2026-10-20 移除 → 2026-10-27 以 OTA 用途重新引入）
原来那套是「连车上的热点 → 网页上刷固件/看诊断」，因为 `FALLBACK_AP_MODE == 0` 时
Web 服务器会**阻塞等 WiFi 连接最多 20 秒**，上电到 485 起步慢，所以整块删掉了。

2026-10-27 重新引入 WiFi，但用途完全不同：只开 SoftAP、不连路由器、**不阻塞**，
跑的是一个极简的 OTA HTTP 服务（`src/ota_server.h`）。刷机这件事改由微信小程序做，
网页那套不再需要。Flash 占用从 7.5% 回到 53.3%（WiFi + WebServer + U8g2 都在里面），
2026-10-28 加了 BLE 之后到 80.8%。

**2026-10-30：热点改成默认关**（`OTA_AP_DEFAULT_OFF 1`）—— 平时纯蓝牙，
要 OTA 时小程序通过蓝牙命令（`6e400005` 写 `0x57`）临时开热点，推完固件重启就回到默认关。
理由和坑见上面 §7。

**2026-10-29 两个关键调整**（都是「车上 WiFi 连不上 + 屏幕闪烁」逼出来的）：

- **热点信道必须是 11，不能用默认的 1** —— BLE 广播固定占 37/38/39（2402/2426/2428MHz），
  WiFi 默认信道 1（2412MHz）正好压在 37 上，共存时手机能扫到热点却连不上。信道 11（2452MHz）最安全。
  发射功率也从 19.5dBm 降到 8.5dBm（手机就贴在车边，功率小一点省电、也不容易把板子拉棕断）。
- **OLED 画屏必须跑在独立 FreeRTOS 任务里**，不能放 `loop()` —— 一屏 1024 字节在 100kHz 下
  要 95ms，放 loop 里会把 485 应答和 WebServer 一起饿死（→ 车速 0 + 错误码 190 + 手机发不出请求）。
  I2C 提到 400kHz（→ ~25ms），并 `#define U8X8_DO_NOT_SET_WIRE_CLOCK` 挡住 u8g2 把时钟改回 100kHz。
  详见 `niu_u1_foc_simulator/NOTES.md` §5.0 和 §7.2。

---

## 分区方案

2026-10-27 改成 A/B 双槽（之前是单 `factory` 分区，**根本没有 OTA 目标分区**，没法 OTA）；
2026-10-28 因为加 BLE 把槽从 1.5MB 扩到 1.75MB（Bluedroid 占 ~700KB，1.5MB 装不下）：

```
nvs,      data, nvs,     0x9000,  0x5000,
otadata,  data, ota,     0xe000,  0x2000,
app0,     app,  ota_0,   0x10000, 0x1D0000,
app1,     app,  ota_1,   0x1E0000, 0x1D0000,
coredump, data, coredump,0x3B0000, 0x50000,
```

每槽 1.75MB，当前固件 1.58MB（80.8%），余量 ~300KB。spiffs 取消了（不存文件）。
`Update.begin(size, U_FLASH)` 会自动挑另一个槽，不用手动选；新固件起不来就回退到旧槽。

**改过分区表必须全量重刷**（`tools/flash.sh`），而且要擦掉 otadata ——
否则 bootloader 还会照着旧的 otadata 去启动 app1。

---

## 文件结构

```
niu/
├── README.md
├── DEVELOPMENT.md              # 本文件
├── package.json                # 只有 miniprogram-ci 一个开发依赖
├── docs/                       # 设计背景 / 协议分析 / 视频提示词
├── diagrams/                   # 接线拓扑图
├── miniprogram/                # 微信小程序 (OTA 客户端 + BLE 遥测)
│   ├── app.js app.json app.wxss
│   ├── project.config.json sitemap.json
│   ├── pages/vehicle/          # 车辆页 (默认 tab): BLE 车速 + 电池 + 诊断
│   ├── pages/upgrade/          # 升级页: 三步引导 (蓝牙开热点 → 连热点 → 传固件)
│   ├── utils/ota.js            # 分块上传
│   ├── utils/firmware.js       # 取固件 (内置模块 / 微信聊天选文件)
│   ├── utils/ble.js            # BLE 连接 + 订阅 + 电池消息分片重组
│   ├── utils/bleLink.js        # 全局 BLE 连接单例 (两个页面共享一条连接)
│   ├── utils/lz.js             # 固件解压 (配套 tools/lz_pack.py)
│   └── firmware/firmware.js    # 构建产物 (压缩+base64 固件), 不入库
├── tools/
│   ├── build_ota.sh            # 编译固件 + 压缩 + 打包进小程序
│   ├── lz_pack.py              # 固件压缩 (极简 LZ77)
│   ├── flash.sh                # 刷机 (擦 otadata + bootloader + 分区表 + app)
│   ├── ota_push_test.sh        # curl 模拟小程序的端到端 OTA 测试
│   ├── ota_open_ap.sh          # 蓝牙开热点 + 电脑连上去 (OTA 测试前置)
│   ├── upload_miniprogram.sh   # miniprogram-ci 上传 / 预览二维码
│   ├── analyze_485_log.py      # 485 日志离线分析 (电脑上看手机拉下来的日志)
│   ├── run_tests.sh            # 自测 (不用板子不用车)
│   ├── test_bus_log.cpp        # 设备侧自测 (日志环形缓冲 / 文本格式 / BLE 包格式)
│   ├── test_miniprogram_ble.js # 小程序侧自测 (消息解析 + 跨语言还原)
│   └── test_vehicle_page.js    # 车辆页自测 (帧分块拼装 / 日志重组与保存)
└── niu_u1_foc_simulator/
    ├── platformio.ini
    ├── partitions.csv
    ├── README.md
    ├── NOTES.md                # 活文档: 接线表 / 协议 / 已知问题
    └── src/
        ├── niu_u1_foc_simulator.ino  # 主程序 (485协议 + 霍尔轮速 + OLED)
        ├── ota_config.h              # OTA 配置
        ├── ota_server.h              # OTA 服务端
        ├── ble_config.h              # BLE 配置
        ├── ble_telemetry.h           # BLE 遥测服务 (通知在独立任务里发)
        ├── ble_battery_msg.h         # 电池信息的 BLE 打包 (纯 C++, 可本机测)
        ├── bus_log.h                 # 485 总线日志环形缓冲 (纯 C++, 可本机测)
        └── bms_protocol.h            # 电池 BMS 报文解析 (纯 C++, 可本机测)
```

---

## 烧录命令

> **2026-10-29 实测：不用手动按 BOOT 了。** esptool 的 `--before default_reset` 通过 CH340 的
> DTR/RTS 就能自动把板子拨进下载模式，连续刷了三次都一次成功。手动按 BOOT 留作备用。

```bash
bash tools/flash.sh /dev/ttyUSB0
```

自动复位失灵时的备用流程（拔 USB → 按住 BOOT → 插回 USB → 立刻跑脚本 → 看到进度后松开）。

编译（不烧录）：

```bash
cd /home/wangxuhui/Documents/niu/niu_u1_foc_simulator
pio run
```

串口：`/dev/ttyUSB0`，波特率 **115200**（USB CDC 调试日志，不是 485）。
