MrWANGXUHUI/niu-u1-foc-simulator/niu_u1_foc_simulator/NOTES.md

# 小牛 U1 FOC 模拟器 — 项目笔记

> 板子: 天问 Pro TW002 (ESP32-C3-DevKitC-02 + CH340K)
> 串口: 485 → V35 ECU (8E1 9600),  UART0 (`/dev/ttyUSB0`) → 调试日志
> 上次更新: 2026-10-30 (iPhone 蓝牙连上 ✅ 根因是微信基础库缺 `wx.onBluetoothDevicesFound`;
> 蓝牙优先架构: WiFi 默认关, 蓝牙遥控开热点)

## 1. 硬件接线 (当前)

| 功能 | GPIO | 备注 |
|---|---|---|
| 485 TX | GPIO 7 | MAX485 DI (自动收发模块, 无 DE/RE 引脚) |
| 485 RX | GPIO 4 | MAX485 RO |
| OLED SDA | GPIO 5 | 板载 SSD1306 128×64, 地址 0x3C |
| OLED SCL | GPIO 6 |  |
| 霍尔轮速 | GPIO 3 | 1 磁钢, 轮周长 1.28m (16x2.50/64-305 实测), **INPUT_PULLUP + 下降沿中断**. 测速用**脉冲间隔** (单磁钢下计数窗口会乱跳), 2s 无脉冲判停转 |
| 调试口 | UART0 | CH340K 接 UART0 (GPIO20/21), `/dev/ttyUSB0` 115200 8N1 |

> ⚠️ **GPIO 9 是 ESP32-C3 的 BOOT 脚**, 不要当普通 GPIO 用. 刷机脚本能自动进下载模式 (见 §4), 手动按 BOOT 只作备用.

> ⚠️ **霍尔传感器必须上拉**: A3144/SSR14Y 都是开集电极 (open-collector) 输出, 内部晶体管关断时输出脚是浮空的,
> 不上拉会读到随机噪声脉冲, 轮速全是乱跳. 代码里用 `pinMode(WHEEL_SPEED_PIN, INPUT_PULLUP)` 打开 ESP32 内部上拉
> (~45kΩ). 如果干扰大或线长, 建议外挂 4.7k~10k 上拉电阻. 磁铁经过时输出被拉低 → **下降沿中断 (FALLING)**.

## 2. 串口与日志

- **485 总线**: 必须在 `Serial1.begin(9600, SERIAL_8E1, 4, 7)`, **不是** 115200 8N1. 错配 1 位都收不到 V35 报文.
- **调试口**: `Serial.begin(115200)`, 仅作调试日志镜像, 不影响 485 总线.
  ⚠️ **`platformio.ini` 里的 `-DCDC_ON_BOOT=1` 对 ESP32-C3 无效** —— Arduino core 2.0.17 只认
  `ARDUINO_USB_CDC_ON_BOOT` (默认 0), 认错了宏, 所以 `Serial` **就是 UART0**, 不是原生 USB.
  板子上的 CH340K (`/dev/ttyUSB0`) 正好接 UART0, 所以**应用日志就在 `/dev/ttyUSB0` 上**
  (ROM 启动日志 `rst:0x1 (POWERON)` 也从这儿出来).
  要改成原生 USB: 把宏换成 `-DARDUINO_USB_CDC_ON_BOOT=1`; 但那之后 `Serial.flush()` 在"电脑接上但没人读"
  时可能长时间阻塞, 而 V35 单次轮询超时只有 ~20ms —— 改之前先把应答路径上的 flush 都去掉.
- **minicom**: 默认不补 CR, 看到 "楼梯" 是正常的, 按 `Ctrl+A U` 打开 "Add Carriage Return" 即可.
- **日志刷屏**: `platformio.ini` 里 `CORE_DEBUG_LEVEL=3` (INFO), `log_v/log_d` 在编译期被替换成 `do {} while(0)`.
  关键: Arduino-ESP32 的 `log_v()` 走 `log_printf` 不走 `ESP_LOGV`, 所以 `esp_log_level_set()` 对它无效, 只能编译期关.

## 3. 485 协议 (V35 ECU 私有协议, DL/T 645 衍生)

帧格式: `68 [DEST_PAIR] 68 [FUNC] [LEN] [DATA+33...] [CHECKSUM] 16`

| 设备 | 地址对 (字节 1+2) |
|---|---|
| FOC 控制器 (本机) | `0x20 / 0xDF` |
| V35 中控 (主节点) | `0x40 / 0xBF` |
| 仪表 | `0x10 / 0xEF` |
| 电池 BMS | `0x31 / 0xCE` |

**关键点**:
- 字节 1+2 标识"这一帧说的是谁": 请求帧 = 目的设备, **应答帧 = 回话设备自己**.
  真车抓包: BMS 回 `31 CE`、仪表回 `10 EF`、FOC 回 `20 DF` —— FOC 应答一律用 `0x20 0xDF`.
  (代码里 `REPLY_WITH_ECU_ADDR` 想改成回 `0x40 0xBF` 时把它设成 1)
- 协议里**没有发送方地址字段** (因为 485 半双工总线隐式知道谁在说话)
- 数据区每个字节发送时 `+0x33` 混淆, 接收时 `-0x33` 反混淆
- 校验和 = 从字节 0 累加到 (不含) CS 字节, 取低 8 位 — **简单 sum & 0xFF**, 不是 CRC
- 轮询周期: V35 大约每 200ms 问一次 FOC

**已验证的示例帧** (Bilibili cv39475428 文章 7 条):
```
FOC read voltage     68 20 DF 68 01 01 38 09 16  (CS=0x09)
FOC read current     68 20 DF 68 01 01 3C 0D 16  (CS=0x0D)
ECU set master       68 40 BF 68 06 01 02 D8 16  (CS=0xD8)
Dashboard display    68 10 EF 68 04 0F ... 33 71 16  (CS=0x71)
... 全部用 sum & 0xFF 对得上
```

**我们 FOC 的应答** (2026-10 按真车抓包 + xzfn 的 ECU 源码对齐):

状态查询 `0x02 05 08` → 12 字节 (`0x05 09` → 14 字节, 多 2 字节 `00 02`):
```
68 20 DF 68 82 0C [30 26 3C 01 00 19 00 00 00 SS 08 00 → +0x33] [CS] 16
                                 └flag_0  保留 保留 保留 保留 保留 │ └SS=车速协议值(0-127) [9]  └flag_1(0x08=驻车) [10]
```
字段定义来自 `niu-ecu/User/niu_series_u.h` 的 `struct PayloadFOCInfoResponse`
(长度必须正好 12, 否则 ECU 判定通信失败并报错误码 190)。线性刻度: 协议值 = round(kmh×25/12), 范围 0..127;
ECU 换算: 仪表速度 = 车速值×12/25。

控制帧 `0x01` 的子命令 (原厂 FOC 的固定应答):
| 子命令 | 应答 | 说明 |
|---|---|---|
| `0x01` | `0x81` + 1 字节 `00` | 状态标志 |
| `0x02` | `0x81` + 16 字节 ASCII | 版本串 `U1E02V11U1E02V11` |
| `0x03` | `0x81` + 16 字节 ASCII | MU 编号 `MU00001B00000001` (兼作解锁命令) |
| `0x04` | `0x81` + 1 字节 `11` | 固件版本 |

系统配置 `0x06` → `0x86` + **空数据** (原厂就是空 ACK)。

## 4. 刷机流程

> **2026-10-29 实测: 不用手动按 BOOT 了.** `tools/flash.sh` 用 esptool 的
> `--before default_reset --after hard_reset`, 通过 CH340 的 DTR/RTS 就能自动把板子拨进下载模式.
> 2026-10-29 连续刷了三次都是一次成功 (2026-10-20 那会儿记的是"必须手动按 BOOT", 现在不成立了).
> 脚本本身还有 30 次重试, 万一自动进不去, 再按老办法手动按 BOOT 也不迟.

```bash
# 直接跑就行
bash tools/flash.sh /dev/ttyUSB0
```

手动进下载模式的备用办法 (自动复位失灵时):

```bash
# 1. 拔 USB
# 2. 按住 BOOT 不放
# 3. 插回 USB (设备进入下载模式)
# 4. 立刻跑 (脚本会持续轮询 30 次连接)
bash tools/flash.sh /dev/ttyUSB0
# 5. 看到 "Writing at 0x..." 进度 → 松开 BOOT
# 6. "Hard resetting via RTS pin..." → 完成
```

`tools/flash.sh` 一次性写 bootloader + 分区表 + app:

```
0x0     bootloader.bin
0x8000  partitions.bin
0x10000 firmware.bin
```

写之前还会先擦掉 **otadata** (0xE000, 0x2000):
改了分区表之后必须这么干 —— 旧的 otadata 还记着"从 app1 启动", 而 app1 在新分区表下
是没刷过的垃圾, bootloader 照着 otadata 去启动它, 表现为"刷完不启动".
擦成全 0xFF 之后 bootloader 找不到有效 otadata, 就退回启动第一个 app 槽 (app0).

`platformio.ini` 里 `board_build.flash_size = 4MB` (TW002 实际是 4MB flash, 不是 8MB).

### ⚠️ 分区表已改成 A/B 双槽 (2026-10-27, 2026-10-28 扩容)

`partitions.csv` 原来是单个 `factory` 分区, **没有 ota_0/ota_1, 根本没法 OTA**.
现在:

```
nvs,      data, nvs,     0x9000,  0x5000,
otadata,  data, ota,     0xe000,  0x2000,
app0,     app,  ota_0,   0x10000, 0x1D0000,
app1,     app,  ota_1,   0x1E0000, 0x1D0000,
coredump, data, coredump,0x3B0000, 0x50000,
```

每槽 1.75MB. **为什么这么大**: 加了 BLE 之后固件 1.58MB ——
Arduino-ESP32 自带的 Bluedroid 蓝牙协议栈一个人就占 ~700KB (WiFi+WebServer+OLED 再加 ~840KB),
1.5MB 的槽装不下. 取消了 spiffs (这个项目不存文件), 空间全给了 app 槽.

**改过分区表之后必须全量重刷一次** (上面那条 flash.sh 就是全量的),
老固件 (factory 分区) 没有 OTA 目标分区, 刷不进新固件.

## 5. 当前 setup() 顺序 (2026-10-30 版)

```
1. Serial.begin(115200)            # 调试日志 (UART0)
2. Wire.begin(5, 6) + setClock(400k) # ← 关键! 必须最早, 防止 u8g2 首刷时 Wire lock 还没创建
3. Serial1.begin(9600, 8E1, 4, 7)  # 485 总线 (RX=4, TX=7)
4. esp_log_level_set(*)            # 静音 ESP-IDF
5. simulator.begin()               # 霍尔 ISR (INPUT_PULLUP + FALLING)
6. u8g2.begin()                    # OLED
7. disp_lock = xSemaphoreCreateMutex() + xTaskCreate(oledTask)   # 画屏挪到独立任务
8. otaService.begin()              # 只注册 HTTP 路由, **不开热点** (WiFi 默认关, 见 §6.7)
9. bleTelemetry.begin()            # BLE GATT 服务 (再放最后, bluedroid 启动要几百 ms + 几十 KB 堆)
10. bleTelemetry.setApToggle()     # 把"开/关热点"的实现注入给蓝牙命令通道
```

`loop()` 里在 `updateWheelSpeed()` 之后调 `otaService.handle()` 和 `bleTelemetry.handle()` (都非阻塞).

> ⚠️ **热点不能开机就开** (2026-10-30): 开了之后 BLE 广播会被共存调度影响, 而且手机一连热点就断网.
> 现在的做法是 `otaService.begin()` 只注册路由, 真正开热点等小程序发蓝牙命令 (§6.7).
> 另外 `server.begin()` **必须等 WiFi 栈起来才能调** —— WiFi 从没初始化过就开监听会
> `tcpip_send_msg_wait_sem: Invalid mbox` 反复 panic, 所以挪到了 `startAP()` 里面.

## 5.0 OLED 必须跑在独立任务里 (2026-10-29 改, 关键)

**画屏绝不能放在 `loop()` 里.** 一屏 1024 字节, I2C 100kHz 下要传 ~95ms; 放在 loop 里的话
这 95ms 里 loop 完全动不了 —— 而 V35 单次轮询的超时只有 ~20ms, 撞上了就是
"这一轮没应答 → 错误码 190 → 车速 0", 也就是**"有时候没有速度"**.

同一个原因还会连带毁掉另外两件事 (2026-10-29 用户报"wifi 连不上 + 屏幕一会亮一会不亮"):

- `otaService.handle()` (WebServer) 也在 loop 里 → loop 被占 95% 的时间,
  HTTP 服务基本没法响应 → **手机连得上热点却发不出请求**
- 屏幕内容在"正常车速 / 错误码 190"之间来回变 → 看着就是**屏幕在闪**

现在的做法:

| 项 | 值 | 为什么 |
|---|---|---|
| 任务 | `oledTask`, 优先级 1 (跟 Arduino 的 loop 任务同级) | 同级靠时间片轮转, 不会饿死 loop |
| 栈 | 4096 字节 | u8g2 缓冲在堆上, 栈够用 |
| 周期 | 200ms | |
| I2C | 400kHz | 1024 字节从 95ms 降到 ~25ms |
| 数据传递 | loop 每 100ms 把快照写进 `disp_state` (互斥量保护), OLED 任务自己读 | loop 里绝不做 I2C |

另外 **`#define U8X8_DO_NOT_SET_WIRE_CLOCK` 必须在 include u8g2 之前** ——
u8g2 每传一页都会调一次 `Wire.setClock(100000)`, 不定义这个宏的话,
我们设的 400kHz 每次都被它改回 100kHz.

台架实测 (模拟 V35 每 200ms 发一帧): 显示满负荷重画时, 应答延迟
**最小 36.6ms / 中位 38.0ms / 最大 44.3ms**, 与显示空闲时基本一致 —— 说明画屏已经不占应答路径了.
(这个 ~38ms 是**调试口**测出来的, 里面含固件故意加的 `delay(3)` + 485 帧 flush,
不是总线上的真实延迟; 真实延迟是"收到最后一字节 → 发出应答", 只有几 ms.)

BLE 解锁功能实现不了, 连带的 WiFi AP / Web 扫描页面 (web_server.h / web_pages.h / web_config.h)
已在 2026-10 整体删除; 2026-10-27 **重新引入 WiFi, 但只用于 OTA**:
只开 SoftAP, 不连路由器, 不阻塞等 WiFi —— 原来阻塞等 WiFi 20 秒正是当年被删掉的原因.

资源占用: Flash **80.8% (1535328 B / 1900544 B)**, RAM **20.4% (66844 B)**.
运行时剩余堆 ~111KB (WiFi + BLE 都在跑).

## 5.1 轮速来源开关 (当前: 霍尔实测)

```cpp
#define USE_HALL_SPEED    1      // 0=写死车速, 1=霍尔实测
#define HARDCODE_SPEED_DM 170    // 写死车速 km/h × 10 (170 = 17.0 km/h), 仅 USE_HALL_SPEED=0 时用
```

`USE_HALL_SPEED = 1` —— 车速来自霍尔脉冲, OLED 和协议值都是实测的.

**测速方式: 脉冲间隔, 不是计数窗口.** 1 个磁钢在 17 km/h 下 250 ms 窗口只期望 0.9 个脉冲,
计数窗口读数会在 0 和 ~24 km/h 之间乱跳. 间隔测速 (相邻两脉冲 = 转一圈) 在 17 km/h 时
分辨率约 0.4%:

```
RPM  = 60 / (脉冲间隔秒数 * 磁钢数)
km/h = RPM * 周长(1.28m) * 60 / 1000
```

**但不是直接用"最近一次间隔", 要取最近 5 个间隔的中位数** (2026-10-28 改, 见 §7 的
"偶发没有车速"一行). 中位数天生抗离群值:

| 情况 | 直接用最近间隔 | 用 5 个间隔的中位数 |
|---|---|---|
| 漏一个脉冲 (间隔变 2 倍) | 车速瞬间掉一半 (17 → 8.5) | 不受影响 |
| 传感器毛刺 (间隔被劈成两半) | 车速瞬间翻倍 | 不受影响 |
| 匀速 17 km/h | 17.0 | 17.0 |
| 匀速 3 km/h (蠕行) | 2.8 | 2.8 |

停转判定: **3 s** 内没有新脉冲 → 车速归 0, 状态帧带上驻车标志 (flag_1 的 0x08).
阈值从 2 s 提到 3 s: 3 s 转一圈 = 1.28 m / 3 s = 1.5 km/h, 低于这个速度仪表本来也看不出差别,
但 2 s 的阈值会让 2~3 km/h 的蠕行整段显示 0 (间隔 1.5~2.3 s 正好卡在阈值上).
另外, 如果某个间隔超过 3 s (说明这段时间是停着的), 这一拍的历史全部作废, 车速从 0 重新收敛.

写死模式 (`USE_HALL_SPEED = 0`) 保留, 方便脱离车轮单独调 485 通信链路:
**写死 17.0 km/h → 协议值 35** (线性刻度 round(17×25/12)=35, 仪表显示约 16.8 km/h).

## 6. OTA 升级 (微信小程序局域网直传)

场景: 车停楼下, 人住 10 楼, 车上没网 —— 改个 bug 不该拆车接线 + 手动按 BOOT.

通道: ESP32 开 SoftAP, 手机连上它, 微信小程序通过局域网 HTTP 直接把固件推进来.
能这么干是因为微信小程序的**局域网例外**: url 写成 `${IP}:${PORT}/${PATH}`、
且手机 IP 和目标 IP 同网段时, **不做安全域校验, 也不用 https**.
所以不用备案域名、不用证书、不用云开发, ESP32 也不需要任何公网出口.

> ⚠️ **2026-10-30 起热点默认是关的** (v1.4.0). 平时纯蓝牙, 要 OTA 时小程序**通过蓝牙命令**
> 临时开热点, 推完固件重启就回到默认关. 详见下面 §6.7「蓝牙优先架构」.

| 项 | 值 (ota_config.h) |
|---|---|
| 热点 SSID | `NIU-U1-OTA` |
| 热点密码 | `niu12345` (WPA2 最少 8 位) |
| IP | `192.168.4.1` |
| 端口 | `8080` |
| 分块大小 | 4096 字节 (原始字节, base64 之后 5464 字符) |
| **热点信道** | **11** (不是默认的 1, 见下) |
| 发射功率 | 8.5dBm (`WiFi.setTxPower`, 默认是 19.5dBm) |

### 为什么热点信道必须是 11

BLE 广播固定用 37/38/39 三个信道 (2402/2426/2428MHz), 而 WiFi 默认的信道 1 (2412MHz)
正好压在 BLE 广播信道 37 上 —— 共存时互相干扰, 表现就是**手机能扫到热点但连不上, 或者连上就掉**.
信道 11 = 2452MHz, 离三个 BLE 广播信道都最远, 也避开了路由器常用的 1~6.

另外 `WiFi.setSleep(false)` 关掉 modem sleep, 否则 AP 会时不时把已连的客户端踢掉.

### 为什么发射功率要降到 8.5dBm

手机就贴在车边 (一两米), 功率再高也没用. 而 WiFi 满功率发射的瞬时电流能到 300mA+,
车上是 48V 降压下来的 5V 供电, 功率越小越不容易把板子拉**棕断** ——
棕断 = 反复重启 = 热点掉线 + 屏幕闪烁, 两个症状一个根因.

### 怎么确认手机到底连上没有

固件每秒打一行 `[AP] NIU-U1-OTA 信道11 客户端:N`:

- **N 一直是 0** → 手机压根没关联上 (不是 HTTP 层的问题): 查信道/供电/iPhone 本地网络权限
- **N ≥ 1 但小程序连不上** → 关联上了, 问题在 HTTP 层: 查 iOS 本地网络权限、域名白名单

### HTTP 接口

| 方法 | 路径 | 请求 | 响应 |
|---|---|---|---|
| GET | `/ota/info` | - | `{ok, version, slot, state, progress, total, freeHeap, slotSize, md5, uptime, apOn}` |
| POST | `/ota/begin` | JSON `{size, md5?}` | `{ok}` |
| POST | `/ota/chunk` | body = base64 文本, 头 `X-Offset` = 原始字节偏移 | `{ok, written, total}` |
| POST | `/ota/end` | - | `{ok, restart}` — 校验 + 切槽 + 重启 |
| POST | `/ota/abort` | - | `{ok}` |

### 三个硬约束 (违反必然出错)

1. **POST body 必须 base64**. Arduino WebServer 把 body 存成 `String(plainBuf)` ——
   按 C 字符串处理, **遇 0x00 就截断**, 原始二进制会坏掉. base64 是纯 ASCII 才安全.
   core 的 `base64` 类只有 `encode` 没有 `decode`, 解码器是自己写的 (`ota_server.h` 的 `b64Decode`).
2. `Update.begin(size, U_FLASH)` 自动挑 `esp_ota_get_next_update_partition()` (另一个槽), 不用手动选.
3. **size 必须传准**. 擦除是随写随擦的 (4KB 一扇区, `Updater.cpp` 的 `_writeBuffer`),
   `Update.begin()` 本身不擦 —— 所以传准 size 就不会白擦 1.5MB 分区.

### ⚠️ 坑: printf 的参数跟格式串错位 → 板子直接重启 (2026-11-02)

**症状: `GET /ota/info` 一发, 板子立刻 Guru Meditation 重启.** OTA 第一步就断, 流程根本走不下去.

```
Guru Meditation Error: Core 0 panic'ed (Load access fault). Exception was unhandled.
MCAUSE : 0x00000005   MTVAL : 0x00000001
```

`MTVAL = 0x1` 是关键: **有个 `%s` 吃到了一个整数 `1`, 把它当指针去解引用**.

根因: `/ota/info` 的 JSON 是 `snprintf` 拼的, 格式串末尾加了 `"apOn":%d`,
但新参数 `(int)apOn_` 被**插在了参数列表的中间** (第 5 个), 而不是最后.
于是参数整体错位一格:

| 位置 | 格式串要的 | 实际传进去的 |
|---|---|---|
| 5 | `%s` (state) | `(int)apOn_` = **1** ← 当成 char* 去读地址 0x1 |
| 6 | `%u` (progress) | `stateName()` (char*) |
| … | … | 全部往后错一格 |

**编译器不会报错** —— `snprintf` 是变参函数, 类型对不上只能运行时炸.
所以这种 bug 只能靠"参数顺序跟格式串一一对应"来防:
现在 `infoJson()` 里每个参数后面都写了注释标明它对应哪个占位符.

> 🔍 **查这个 bug 时走过的弯路, 记一下免得下次再踩**:
> panic 的栈底有一堆 `mbedtls_sha256` / `esp_sha_dma` / `gdma_connect` 的帧,
> 看着像"WiFi 加密硬件跟 SHA 抢 GDMA 通道". 其实是**假线索** ——
> FreeRTOS 会复用任务栈, 那几帧是 WiFi 任务之前留下的旧数据, 跟这次崩溃无关.
> 判断依据: 去掉 `ESP.getSketchSize()` (它内部确实会 `esp_image_verify()` 算 SHA)
> 之后, **崩溃地址一点没变** (`MEPC` 还是 `0x40058e94`).
>
> 真正的二分办法: 加几个只拼一部分参数的临时路由, 逐个测.
> 结果每个参数单独拼都不崩, 全部拼一起才崩 —— 才反应过来是错位.

顺带把 `ESP.getSketchSize()` 换成了直接查分区表 (`running->size`):
那个函数每次调用都要把 1.5MB 的镜像 SHA256 重算一遍, 慢而且跟 WiFi 加密抢硬件通道.

### 失败保护

- 校验不过 / 新固件起不来 → bootloader 回到另一个槽, 老固件照跑 (`Update.end()` 内部 abort)
- 传输中断电 → 备用槽写了一半, 当前槽不受影响, 下次上电照旧
- Arduino 的 Updater 会把开头 16 字节延后写, 写了一半的镜像根本起不来

OTA 期间 OLED 切到 OTA 画面 (SSID + IP + 进度条), 完成后恢复速度画面.
485 不受影响: `server.handleClient()` 非阻塞, 4KB 一块每块只阻塞几 ms, V35 的 200ms 轮询周期不受影响.

### 小程序端

- 源码在仓库根的 `miniprogram/`, 固件由 `tools/build_ota.sh` 打进包里
- **端到端验证 (不用手机)**: `bash tools/ota_push_test.sh` —— 用 curl + base64 模拟小程序全流程
  (2026-11-02 台架跑通: 1.59MB 全传完, `/ota/end` 返回 `{"ok":true,"restart":true}`,
  板子重启后运行分区从 `app0` 变成 `app1`)
- 上传体验版 / 生成预览二维码: `bash tools/upload_miniprogram.sh preview` / `upload`
  (miniprogram-ci 命令行, 不需要开发者工具; 要 AppID + 上传私钥 + 公网 IP 白名单)

⚠️ **小程序代码包只收白名单扩展名** (.js / .json / .wxml / .wxss / 图片 / 音频 / …),
`.bin` 和 `.txt` **不在白名单里** —— 直接把 `firmware.bin` 放进包里会在上传时被悄悄丢掉,
小程序里读不到. 所以 `build_ota.sh` 把固件转成 base64 塞进 `miniprogram/firmware/firmware.js`.

⚠️ **主包上限 2MB, 所以还得压缩**. 固件 1.59MB → base64 是 2.1MB, 超限.
`tools/lz_pack.py` 是一个极简 LZ77 (68%), 压完 1.08MB → base64 1.44MB, 装得下.
解码在小程序里做 (`miniprogram/utils/lz.js`), 格式见那个文件的头注释.
**改了这个格式, `lz_pack.py` 和 `lz.js` 必须同步改.**

> ⚠️ **现在整包 zip 是 2,096,904 字节, 离 2MB 上限 (2,097,152) 只剩 248 字节.**
> 固件再大一点点就上传不了了. 以后加功能前先看下这个数.

### 台架验证 OTA 用的脚本

| 脚本 | 作用 |
|---|---|
| `tools/ota_open_ap.sh` | 蓝牙发 `'W'` 开热点 + 电脑连上去 (OTA 前置) |
| `tools/ota_push_test.sh` | curl 模拟小程序全流程, 传完对比运行分区 |
| `tools/ota_probe.sh` | 只发一个 HTTP 请求 + 看板子会不会被这一个请求搞挂 |

**用 `hcitool`/`gatttool` 前要先停 bluetoothd** (它占着适配器, gatttool 会报
`No route to host`); 扫广播还要 root, 所以用 `sudo hcitool lescan --duplicates`.
测完记得把 bluetoothd 起回来 (`systemctl unmask bluetooth && systemctl start bluetooth`).

## 6.8 小程序界面重构 (2026-11-02)

原来是一个页面里塞了遥测 + OTA 两件事, 逻辑很绕. 现在拆成两个 tab:

| tab | 页面 | 干什么 |
|---|---|---|
| 车辆 (默认) | `pages/vehicle/vehicle` | 连蓝牙 → 大字车速 → 电压/电流/转速/错误码 → 电池 → 折叠的诊断和 485 原始帧 |
| 升级 | `pages/upgrade/upgrade` | 三步引导: ①蓝牙开热点 → ②手机连热点 → ③传固件 |

**关键设计: 蓝牙连接提到全局单例** (`miniprogram/utils/bleLink.js`).
两个页面都要蓝牙, 如果连接只存在页面里, 两个页面各连一次、互相踢掉, 用户一脸懵.
现在 `bleLink` 管连接, 页面只订阅状态 (`onState`) 和数据 (`onData`).

顺带修掉的老 bug: 通知回调原来在页面 `onLoad` 里注册但 `onUnload` 没注销 ——
页面来回进出就会重复注册, 同一批数据被处理多次. 现在统一在 `bleLink` 里注册一次, 按 UUID 分发.

**升级页为什么是三步而不是一个按钮**: OTA 需要"手机连热点"这个用户必须手动做的动作,
而"设备开热点"是设备自己的动作. 混在一起用户不知道该干嘛. 拆成三步, 每步都有明确的完成标志.

**第 ① 步的完成标志是"蓝牙命令写成功", 不是 HTTP 探测** ——
手机这时还没连热点, 没有 192.168.4.x 网段, HTTP 必然不通, 分不清是"热点没开"还是"手机没连热点".
命令写成功 = 固件收到并执行了 = 热点会开.

**升级完成后**: 设备重启 → 热点自动关 (默认关) → HTTP 探测不再通.
所以成功标志是 `ota.end()` 返回那一刻, **不是**之后的探测. 页面这时把 `info` 清掉,
并提示"去车辆页确认版本" —— 蓝牙不受影响, 那边能问到新版本号.

### ⚠️ 改页面路径前一定要留跳板页 (2026-11-02 踩的坑)

把 `pages/telemetry` 改名成 `pages/vehicle` 之后, 小程序**默认打开时报**
"该页面不存在, 你可以进入小牛esp32助手首页获取更多服务" ——
但**点左上角「首页」完全正常**.

原因: 小程序可以带着一个**页面路径**被打开, 而这个路径可能记在好几处:

- 公众平台「设置 → 基本设置 → 小程序主页」里设的路径
- 以前生成的老小程序码/二维码
- 微信里的历史分享链接、收藏的旧入口

这些都指着**改名前**的 `pages/telemetry/telemetry`. 那个路径一旦不存在,
微信就报"页面不存在", 用户连小程序都进不去.
而点左上角「首页」走的是 `pages[0]` (`pages/vehicle/vehicle`), 所以是好的 ——
**这个差别就是判断依据: 首页能进、默认进不去 = 默认路径是陈旧的.**

**修法: 旧路径留着同名空页, 进来就跳到新的默认首页.**
`pages/telemetry/telemetry` 和 `pages/index/index` 现在都只是跳板:

```js
Page({
  onLoad() {
    wx.switchTab({ url: '/pages/vehicle/vehicle' })   // tabBar 页面只能用 switchTab
  }
})
```

注意 **tabBar 页面只能用 `wx.switchTab` 跳**, `redirectTo`/`navigateTo` 跳不过去.

> ⚠️ **跳板要跳「车辆」, 不是跳「升级」**.
> 旧版 `app.json` 的 `pages[0]` 是 `pages/index/index` —— 也就是说公众平台记下来的
> 「小程序主页」正是这个路径, 所以**默认打开走的就是它**.
> 一开始我把 `pages/index/index` 跳到了「升级」, 结果用户默认打开落在升级页上,
> 而新的 `pages[0]` 是「车辆」. 跳板必须跟新的默认首页保持一致.

> 顺带: 排查这个的时候, 上传日志里只列 `.js/.wxml/.wxss`, **看不到编译器重新生成的 app.json**
> (它是由 `app.json` + 页面 json 重新拼出来的). 用 `tools/dump_appjson.js` 本地跑一遍编译,
> 直接把生成的 app.json 和文件清单打出来, 比猜快得多.

## 6.5 BLE 遥测 (手机不连 WiFi 也能看车速)

OTA 走 WiFi 热点 —— 手机一连热点就断网, 推完固件还得手动切回自己的 WiFi.
看车速不需要断网, 所以另开一条 BLE 通道: 蓝牙直连, 手机照常上网.

固件侧 `src/ble_telemetry.h` (配置在 `src/ble_config.h`):

| 项 | 值 |
|---|---|
| 设备名 | `NIU-U1-BLE` (小程序按前缀 `NIU-U1` 找) |
| Service | `6e400001-b5a3-f393-e0a9-e50e24dcca9e` |
| 遥测特征 | `6e400002-…` notify, 20 字节小端 (前 12 字节是旧格式, 老小程序照样能解) |
| 485 帧特征 | `6e400003-…` notify, 总线上抓到的原始帧 (最新一帧, 分块带块序号) |
| 电池特征 | `6e400004-…` notify, 电池信息 (BMS 解析结果 + 诊断, 分片消息) |
| 命令特征 | `6e400005-…` write, 单字节命令 (见 §6.7) |
| 日志特征 | `6e400006-…` notify, 485 总线日志 (v1.5.0 加, 见 §6.8) |

> **BLE 名字为什么改成 `NIU-U1-BLE`** (2026-10-29): 原来跟 WiFi 热点同名 (`NIU-U1-OTA`),
> 在手机的蓝牙列表里跟 WiFi 网络混在一起分不清. 小程序那边只按前缀 `NIU-U1` 匹配, 不受影响.

### 用蓝牙要做什么准备

**不需要**先在系统设置里配对/连接 —— BLE 是直连, 小程序自己发起.
但权限必须给, 否则小程序会直接失败:

| 平台 | 要做什么 |
|---|---|
| iOS | 系统蓝牙开着; **微信** 要有蓝牙权限: 设置 → 隐私与安全性 → 蓝牙 → 微信. 第一次点「连接」时微信会弹「微信想要使用蓝牙」, 点允许 —— 如果之前点了拒绝, 就得手去设置里改. (推固件还要 iOS 的「本地网络」权限, 那是另一条) |
| Android | 系统蓝牙开着; 微信要「附近设备/蓝牙」权限; **扫蓝牙还要「定位」权限** (Android 6+ 强制), 不给就一个设备都扫不到 |

小程序侧已经把微信的 errMsg 翻译成能动手解决的提示了 (`miniprogram/utils/ble.js` 的 `explainBleFail`),
而且扫不到时会把它**实际扫到的设备名列出来** —— 要是列表里有 `NIU-U1-BLE` 却还是连不上,
那就是权限问题, 不是设备问题.

遥测载荷 (20 字节小端):

| 偏移 | 字段 | 含义 |
|---|---|---|
| 0-1 | speed_dm | 车速 ×10 (霍尔实测) |
| 2-3 | rpm | 轮速转速 |
| 4-5 | voltage | 电压 ×10 (V) |
| 6-7 | current | 电流 ×10 (A, 有符号) |
| 8 | protocol_speed | 485 协议车速值 (0-127) |
| 9 | error | 错误码 |
| 10 | unlocked | 1 = 已解锁 |
| 11 | flags | bit0: 刚收到过 485 帧 |
| 12-13 | q_count | 收到 V35 状态查询的次数 |
| 14-15 | a_count | 我们回出的应答次数 (应与 q_count 相等) |
| 16-17 | pulse_count | 霍尔脉冲累计数 (低 16 位) |
| 18 | bad_cs | 校验和不对的帧数 |
| 19 | interval_x10 | 最近一次脉冲间隔 (10ms 单位) |

后 5 个字段是**诊断用的**: 骑车时看小程序就能分清是谁的问题 ——
轮询数一直涨 = 总线通; 应答数跟着涨 = 我们答上了; 脉冲数不涨 = 霍尔/磁钢没信号, 车速自然是 0.
(计数是 16 位会回绕, 小程序端按差值算速率.)

485 帧一帧最长 64 字节, 蓝牙一包最多 20 字节 → 分块推, 小程序端攒到 `0x16` (帧尾) 为止算一整帧.

### 电池信息 (BMS) 的消息格式

一条特征上跑三种消息, 每条通知带 3 字节头 `[类型][片号][总片数]`, 类型 1=状态 2=单体电压 3=型号串.
状态 17 字节: 标志 / 电量% / 总电压0.1V / 电流0.1A / 温度个数 / 5×温度 / 单体串数 / 最低单体mV / 最高单体mV.
单体电压: 每格 2 字节 mV. 型号串: ASCII.
打包代码在 `src/ble_battery_msg.h` (纯 C++, 不依赖 Arduino, 可以在 PC 上编译跑测试).

**两端对得上的验证方法** (不用车, 不用板子): 固件的打包函数 `bleBatteryPack*` 在 PC 上编译,
把真车抓包里的 BMS 报文解出来打成分片 → 喂给小程序的 `handleBatteryChunk` → 出来的值
必须跟原始报文一致. 这个校验把「固件改了格式但小程序没跟着改」这类错挡在上传之前.

**坑: 分片要按"收齐了几片"算, 不能按"收到几次"算**: 蓝牙会重传, 同一片来两次的话,
按次数算会提前凑够总片数, 拼出来的数据少一片 —— 而固件侧是"变了才推", 这条消息就永远补不回来了.

### 坑: 断连以后不会自动重新广播

Arduino 的 `BLEServerCallbacks::onDisconnect` 里调 `advertising->start()` **没用** ——
那个回调跑在蓝牙任务里, 这时候 GAP 状态机还没处理完断连, 启动广播被静默丢掉,
结果就是**设备再也不广播, 手机再也扫不到它** (实测踩过: 连一次之后设备就"消失"了).

必须把重新广播**延后到主循环** (`ble_telemetry.h` 的 `handle()` 里, 断开 300ms 之后再启动).
另外加了兜底: 断开超过 30 秒还没广播出去就再试一次.

### 坑: 重连后单体电压和型号串不再推送

单体电压和型号串是**变了才推** (哈希比对), 但手机重连后小程序那边的状态是空的 ——
哈希没变, 这两个消息就永远不会再发, 结果电池面板只剩状态, 没有单体条也没有型号串.
所以 `handleDisconnect()` 里要把两个哈希清零, 让重连后的第一次通知重新推一遍.

### 其它注意

- Arduino-ESP32 2.0.17 自带的 `BLE` 库在 C3 上能编能跑 (Bluedroid, 无经典蓝牙),
  PlatformIO 不用额外配置就能找到它. 但它吃内存: bluedroid 初始化要几十 KB 堆,
  所以 `begin()` 放在 setup 最后, 失败也不影响 485.
- WiFi SoftAP + BLE 可以同时开 (C3 单射频, IDF 负责时分), 实测 OTA 传输期间 BLE 照常工作.
- 蓝牙协议栈占 ~700KB flash —— 这是分区表要扩容到 1.75MB/槽的直接原因.

## 6.6 电池 BMS 报文解析 (2026-10-28 加)

485 是半双工总线, 所有节点都能听到别人说的话 —— V35 问 BMS「电量多少」,
BMS 的应答我们虽然不是收信人, 但在总线上照样能收到. 于是把它解析出来给小程序看.

**我们不冒充 BMS, 也不应答任何 BMS 请求** —— 只听.

### V35 怎么问 BMS

V35 用功能码 `0x02` 加两个字节问 BMS, BMS 用 `0x82` 回. 反混淆 (每个字节 -0x33) 后:

| V35 的请求 | BMS 应答长度 | 内容 |
|---|---|---|
| `2d 0f` | 15 | 电池状态 (每次轮询都问, 约 3 次/秒) |
| `09 24` | 36 | 型号串 |
| `02 2b` | 43 | 型号串 (前面多 7 字节头 `14 04 55 55 55 55 01`) |
| `3c 28` | 40 | 单体电压 |

### 15 字节状态帧的字段布局

| 字节 | 含义 | 单位 |
|---|---|---|
| `[0..1]` | 总电压 (**大端** u16) | 0.1V (`0x0219` = 537 → 53.7V) |
| `[2..4]` | 未知 | |
| `[5]` | 电流 | A (实测 0..38) |
| `[6]` | 电量 | % |
| `[7..9]` | 未知 | |
| `[10..14]` | 5 个温度 | °C |

### 40 字节单体电压帧

前面是单体电压 (**大端** u16, 单位 mV), 一直到第一个 0 为止, 后面是保留的 0.
13 串的 48V 电池 = 13 × 3.7V, 加起来跟状态帧的总电压对得上 (交叉验证过).

### 型号串

36 字节那帧串在开头, 43 字节那帧串在第 7 字节之后. 16 字节 ASCII, 形如
`BUS9LN2S60900065` / `BUM9L62S43500598`.

### 字段布局的来源与验证

布局来自 [xzfn/scooter-repair](https://github.com/xzfn/scooter-repair) 的 `docs/niu-u-civic.md`
「BMS返回的主要是电量」一节, 并用该仓库的真车抓包日志**逐字段核对过**:
7 个日志文件共 2041 帧 BMS 报文, 解析成功率 100%, 校验和错误 0,
状态帧的总电压跟单体电压求和一致 (48.6V vs 48.69V, 53.3V vs 53.4V).

### ⚠️ 这台车的 BMS 回的是 55 字节 (2026-11-06 真车日志发现的)

上面记的"V35 用 `2d 0f` 问 BMS, BMS 回 15 字节状态" —— **这台车不是这么回事**.
2026-11-06 抓的日志 (docs/niu485-20261106-090017.log) 里:

| | V35 的请求 | BMS 的应答 |
|---|---|---|
| 文档那台车 | `2d 0f` | 15 字节 (状态) |
| **这台车** | **`2d 37`** | **55 字节** = 15 字节状态 + 40 字节单体电压 |

55 字节帧的布局 (反混淆之后):

```
[0..1]  总电压  大端 u16, 0.1V      (实测 461 → 46.1V)
[2..4]  未知   (恒为 00 00 00)
[5]     电流   (见下面的单位问题)
[6]     电量 %                       (实测 63)
[7..9]  未知   (恒为 00 01 07)
[10..14] 5 个温度 °C                  (实测 4/4/4/4/6)
[15..54] 40 字节单体电压帧: 13 个大端 u16 (mV) + 后面保留的 0
         (实测 13 串, 3.47~3.55V, 求和 45.44V —— 跟状态里的 46.1V 对得上)
```

前 15 字节跟文档记的 15 字节状态帧**布局完全一致** ✓ (电压/电流/电量/温度四个位置
都能对上), 后 40 字节也跟文档记的单体电压帧一致 ✓ (大端 u16 mV, 到第一个 0 为止).
所以就是**两段拼在一帧里** ✓.

**我们原来只认 15/40/43 字节 → 整帧被丢掉 → 小程序上电量一直是空的.** ⚠️

**电流的单位**: 原始字节实测 76~159. 按文档记的"A"算就是 46V × 159A = **7.3kW**,
踏板车没那么大的功率; 按 **0.1A 一档**算 (7.6~15.9A, 350~730W) 才合理.
两台车的 BMS 不是一套 (问法都不一样), 电流档位不一样不奇怪.
代码里用 `BMS_CURRENT_SCALE` (现在 10) 控制, 换车不对就改成 1.

### 改了 485 的分帧方式 ⚠️

原来靠 `0x16` 找帧尾, 现在改成**靠长度字节**: 第 6 个字节是数据长度, 整帧 = `6 + len + 2`.
原因: 数据区里也可能出现 `0x16` (明文 `0xE3` + `0x33` 混淆后正好是 `0x16`),
靠 `0x16` 分帧会把一帧劈成两半, 后面那半被当成新帧 → BMS 应答解析不出来.
分帧代码在 `.ino` 的 `rxPush()` / `rxResync()`.

### 调试: 没有车也能验

调试口 (`/dev/ttyUSB0`) 里敲 `[TX] 68 31 CE 68 82 0F ... 16` 回车, 就把这帧喂进 485 解析链路,
不用拆车接线就能验证 BMS 解析. 代码在 `.ino` 的 `DEBUG_INJECT_485` 块 (编译期开关).

## 6.7 蓝牙优先架构 (2026-10-30 加, v1.4.0)

**一句话: 平时只用蓝牙, WiFi 只在 OTA 那几分钟开一下.**

### 为什么改

原来的设计是开机就开 WiFi 热点, 小程序靠 HTTP 推固件. 问题:

1. **手机一连热点就断网** —— 推固件的时候手机上不了网
2. **SoftAP 一直在发信标, 白耗电** —— 车上是电池供电
3. **两边射频同时用, BLE 广播节奏会被共存调度影响** —— 手机扫码慢
4. OTA 一年碰不到几次, 没必要常开

改成: **WiFi 默认关** (`ota_config.h` 的 `OTA_AP_DEFAULT_OFF 1`), 小程序要升级时
**通过蓝牙发一个字节把热点临时打开**, 推完固件板子重启, 自然回到默认关的状态.

### 蓝牙命令通道

新增特征 `6e400005-b5a3-f393-e0a9-e50e24dcca9e` (write + read + notify):

| 字节 | 含义 | 回包 |
|---|---|---|
| `0x57` (`'W'`) | 开 OTA 热点 | `[0x57, 0x01]` |
| `0x58` (`'X'`) | 关 OTA 热点 | `[0x58, 0x01]` |
| `0x56` (`'V'`) | 问固件版本号 | `['V', "1.4.2"]` (v1.4.2 加) |
| `0x4C` (`'L'`) | 取 485 总线日志 (v1.5.0 加) | 日志特征上的一串包 |

小程序侧 (`miniprogram/utils/ble.js`): `writeCommand(deviceId, cmdChar, 'W')`.
固件侧 (`ble_telemetry.h`): `BleCmdCb::onWrite` 收到后**只排队**, 由主循环 `handle()` 执行 ——
BLE 回调跑在蓝牙任务里, 在那边动 WiFi 会跟共存调度打架.

`'V'` 是给「车辆」页显示固件版本用的: 平时 WiFi 是关的, 问不到 `/ota/info`,
只有蓝牙这条路能问. 版本号由 `.ino` 注入 (`bleVersionProvider` → `OTA_FW_VERSION`).

`'L'` 是取日志用的, **带参数**: 写 3 字节 `[0x4C][偏移 u16 小端]`,
偏移 = 从整份日志的第几个字节开始 (手机发现丢包时用来让设备重发缺的那段),
`0xFFFF` = "拉完了, 解冻". 单字节写法和老命令一样.

> ⚠️ **命令字节只认这几个**. 派发逻辑是"不是 `'V'`/`'L'` 就当开关热点" ——
> 所以收到别的字节会当成 `'X'`, **把热点关掉**. 以后加新命令记得同步改派发分支.

### 三个必须知道的坑

**1. 写命令必须用带 param 的 `onWrite` 重载**

```cpp
void onWrite(BLECharacteristic* ch, esp_ble_gatts_cb_param_t* param) override;
```

废弃版 `onWrite(pCharacteristic)` 里的 `getValue()` **拿不到刚写进来的字节** ——
实测写 `0x57` 读回来是 `0x00`. 要用 `param->write.value[]`.

**2. 命令字节取最后一个, 不是第一个**

`gatttool` 之类的工具写 `0x57` 会被当成 2 字节大端 (`00 57`), 取头就拿到 `0x00` 了.
小程序用的是 `wx.writeBLECharacteristicValue` (原始 ArrayBuffer), 不会有这问题,
但固件取最后一个字节更保险.

**3. 重新开热点时 HTTP server 必须重绑**

`WebServer::begin()` 内部先 `close()` 再监听, 所以 `startAP()` 里**每次都调** `bindServer()`.
不重绑的话「关热点再开」之后 HTTP 端口收不到任何请求 (lwIP 被 `WIFI_OFF` 拆过, 老 socket 废了).

### 关热点不能用 `WiFi.mode(WIFI_OFF)`

`WIFI_OFF` 会走 `espWiFiStop()` → `esp_wifi_stop()` + lwIP 反初始化, **整个 WiFi 协议栈被拆掉**.
改成只切模式: `esp_wifi_set_mode(WIFI_MODE_NULL)` —— 热点停止广播, 协议栈留着,
`startAP()` 随时能开回来.

### 广播包布局 (iPhone 能不能扫到的关键)

| 包 | 内容 |
|---|---|
| 主广播包 | Flags(0x06) + 完整设备名 (10 字节) |
| 扫描回应 | 完整设备名 + 128 位 Service UUID (共 30 字节, 在 31 字节上限内) |

**名字必须在主广播包里.** 库默认行为是把名字和 UUID 全塞扫描回应, 主广播包只有 Flags ——
而扫描回应只有**主动扫描**才收得到 (手机发 SCAN_REQ). iPhone 后台的小程序是**被动扫描**,
收不到扫描回应, 看到的就是"一个没名字的设备", 直接被名字过滤掉.
Linux 用主动扫描所以一直能看到 —— 台架上测不出这个坑.

> ⚠️ 这个布局问题**不是** iPhone 扫不到的根本原因 (那个是微信基础库版本, 见 §7.3),
> 但布局本身该改 —— 名字放主广播包对所有扫描方式都稳.

扫描回应里加 UUID 是为了"按服务 UUID 过滤"的扫描器也能匹配上. 注意 31 字节上限:
Flags(3) + 名字(12) + UUID(18) = 33 **超了**, `addData` 会静默丢弃 ——
所以扫描回应里**不放 Flags**, 刚好 30 字节.

### 实测数据 (2026-10-30, 台架)

用 `hcitool lescan --duplicates` 抓 12 秒原始广播包:

| 状态 | 广播包数 | 折算频率 |
|---|---|---|
| WiFi 关 | 100 | ~8.3/秒 (间隔 ~120ms) |
| WiFi 开 | 117 | ~9.75/秒 |
| WiFi 开 + 有客户端在线 | 117 | ~9.75/秒 |

> ⚠️ **踩过的坑: 别用 btmon 的次数下结论.** btmon 抓的是控制器**重复过滤之后**的上报,
> 看起来像"16 秒才广播一次" —— 那是过滤器的假象, 不是真的限流.
> 要看真实节奏必须用 `hcitool lescan --duplicates` (要 root, 且要先停 bluetoothd).

### 台架已验证

- BLE 写 `0x57` → 热点起来 (信道 11 / 192.168.4.1:8080) ✅
- BLE 写 `0x58` → 热点关 ✅
- BLE 写 `0x56` (`'V'`) → 回 `V1.4.2` ✅ (gatttool 读特征值核对过)
- 开→关→开→关 连做 4 次, 无 panic 无复位 ✅
- 广播包内容用 btmon 核对过: 主广播包带完整名字 ✅
- **HTTP 端到端也通了** (2026-11-02): `tools/ota_push_test.sh` 全流程跑完,
  运行分区从 `app0` 变成 `app1` ✅ (见 §6)

**还没验证的**: 真机上的小程序 UI (iPhone 上扫码点按钮), 得用户实测.

## 6.8 蓝牙通知搬进独立任务 + 485 总线日志 (2026-11-04 加, v1.5.0)

### 为什么动它: "连上蓝牙后 BMS 没数据"

现象: 手机连上蓝牙后, 小程序车速正常、485 原始帧也有, **但电池面板一直是空的**.

链路挨个查过了 —— BMS 解析逻辑没问题 (2041 帧真车抓包验过), BLE 电池消息格式也没问题.
那就只剩**时机**. 硬约束在 §3:

> V35 单次轮询的超时只有 **~20ms**, 超了 ECU 置错误码 190, 车速显示 0.

而 1.4.4 的 `bleTelemetry.handle()` 是**在主循环里直接发 notify 的**, 而主循环同时是
485 应答的路径. 一次通知突发 (最多 8~9 包) 就能把应答堵过 20ms.
**手机不连蓝牙的时候没有这些包, 平时反而不暴露** —— 跟"连上才出问题"的现象对得上.

包的顺序也解释了"车速有、电池没有": 遥测是每次突发的**第一个** (总发得出去),
电池状态是**最后一个** (最先被丢).

### 改法 (跟 OLED 任务一个思路, §5.0)

- 主循环只往快照里塞数据 (几十字节 memcpy + 互斥量), 立刻返回
- **所有通知在独立的 `ble` 任务里发** (栈 4KB, 优先级 1)
- 通知量压下来: 电池状态 5Hz→2Hz; 单体电压变化 ≥3mV 才推; 485 帧只推最新一帧
- **命令的执行仍然留在主循环** —— WiFi 开关必须在主循环做 (BLE 任务里动 WiFi 跟共存调度打架)

### 485 总线日志 (新特征 `6e400006`, notify)

手机上看到的 485 帧是「每 200ms 推最后一帧」的采样, 总线实际约 30 帧/秒 ——
**八成的帧看不到, 拿这个离线分析是白搭**. 所以日志记在**板子上**:

| 环节 | 实现 |
|---|---|
| 记录 | `src/bus_log.h`: 256 条记录的环形缓冲, 每条 = 时间戳(u32) + 方向 + 帧字节. **RX 和 TX 都记** |
| 拉取 | 手机写 `'L'` 命令 (参数 = 起始字节偏移), 设备转成文本分块推回来. 拉取期间**冻结**日志 |
| 包格式 | `[0]'L' [1]flags(bit0=最后一块) [2..5]偏移 [6..9]总长 [10..]文本` |
| 保存 | 小程序写文件到沙箱 → `wx.shareFileMessage` 发进微信 → 电脑上保存. 老微信没这 API 就退回复制文本 |
| 分析 | `tools/analyze_485_log.py` |

**为什么带偏移**: 蓝牙通知可能丢包. 有偏移手机才能发现缺口, 让设备从缺的地方重发
(日志在设备那边是冻结的, 重新生成的文本跟刚才一模一样, 偏移对得上).

**为什么拉取时要冻结**: 传输要几秒, 这几秒总线还在跑, 新帧会把最老的内容顶掉 ——
传到一半前面的数据就变了, 日志废了.

**存不下更长历史**: 环形缓冲 16KB (RAM 只剩 ~110KB, 这是能给的极限), 约 8~9 秒.
想更长得上 flash, **但不行** —— 擦扇区会堵住 CPU 100~300ms, 当场把 485 时序搞坏.

### BMS 诊断计数 (小程序上直接显示)

固件的 `BmsDiag` 随电池特征的第 4 种消息 (类型 4) 推过来:

```
BMS 应答     总线 42 帧 · 解析成功 40
解析错误     校验错 1 · 长度错 1 · 未知长度 0
最近一次     距上次 BMS 应答 0.3 秒
```

| 现象 | 说明 |
|---|---|
| 总线 0 帧 | BMS 压根没回话 (电池侧/接线/它不轮询) |
| 总线有帧、成功 0 | 收到了但被干扰或被撞坏 (校验和错) |
| 成功 > 0 但小程序没数据 | 固件正常, 问题在蓝牙这一段 |

> ⚠️ 统计要分清**请求和应答**: 地址对 `31 CE` 的帧有两种 —— V35 问 BMS 的请求
> (功能码 `0x02`) 和 BMS 回 V35 的应答 (`0x82`). 只有后者才算"BMS 回话了".

### ⚠️ GATT 服务的 handle 不够, 第 5 个特征静默失灵 (2026-11-04 踩, 1.5.1 修)

第一次做 485 日志, "保存日志"按钮**永远是"导出中", 一次都没成功过**.
根因不在日志逻辑, 在 BLE 服务本身:

Arduino BLE 里**每个特征占 3 个 handle** (特征声明 + 值 + CCCD 描述符),
服务默认只给 15 个 (扣掉服务自己的 1 个 = 14 个可用).
原来 4 个特征占 12 个刚好够用; 加到第 5 个 (日志特征) 就要第 15 个 → **越界**,
`esp_ble_gatts_add_char` 失败, 特征**根本没建出来**.

症状特别坑, 因为**前 4 个特征一切正常** (车速、电池都对):

- 手机订阅不到日志特征 → `ble.subscribe()` 抛异常, 被 try/catch 吞了 → 连日志都没有
- 板子往一个 handle 都没拿到的特征上 notify() → 什么也发不出去
- 手机那边就一直等 → "导出中"

修法: `server->createService(BLE_SERVICE_UUID, 25)`.
**教训**: 加 BLE 特征的时候 handle 数量要自己算, 别用库的默认值.

顺带修的两处:

- **传输超时误杀**: "手机多久没来要下一包"(20 秒)就掐断传输, 但这个计时器
  **发包时不刷新** —— 包小的时候(对端 MTU 小)整份日志要传几十秒, 中途被自己掐了.
  改成每发一包续一次命.
- **包大小**: 手机把协商出来的 MTU 一起告诉设备 (`wx.getBLEMTU`),
  设备取两边**小**的那个. 报大了会被蓝牙协议栈**截断**, 手机收到半个包 →
  偏移对不上 → 一直要求重发 → 永远拉不完.

小程序侧加了两道保险: 固件没有日志特征时按钮直接禁用并说明原因;
拉取 12 秒没动静就报错 (不再无限转圈).

### 测速的自适应毛刺闸门 (1.5.1 加)

用户反馈"速度有时候跳变, 匀速骑一会就准, 车最高 40km/h".

1.4.4 那道闸门是**绝对阈值 25ms**, 挡的是 6ms 那种振铃 (车速离谱 40 倍就是它).
但骑车时真间隔是几百毫秒 (40km/h → 115ms), **50~60ms 的振铃照样穿得过去** →
混进历史 → 中位数被污染 → 车速跳来跳去, 匀速骑一会 (中位数收敛) 才准.

加第二道: **拿最近一次可信间隔当参照**, 比它短 40% 以上的判为毛刺.
物理上不可能是真加速 (一个间隔里速度翻一倍, 踏板车做不到); 加速时参照量自己会变小,
不会误杀.

- ISR 里用 `last_good_interval_us` (主循环更新) → 毛刺在**进时间戳之前**就挡掉
- 主循环里再用最近中位数挡一次 (双保险)

> ⚠️ **这段后来被推翻了** (1.5.3): "加速时参照量自己会变小, 不会误杀" 是错的 ——
> 门槛**没有上限**时, 猛加速会误杀真脉冲, 而且是**自锁**的, 车速冻在真实值的一半.
> 详见下面 §"车速冻在 19.6km/h". 现在的做法: 参照量用中位数 + 门槛加 80ms 上限.
小程序诊断区加了"测速波动 (5 秒)" —— 骑车时一眼看出稳不稳.

> **已知限制**: 主循环 100ms 才处理一次脉冲间隔, 车速超过 ~90km/h 时一个周期可能来
> 两个脉冲只算了一个 → 速度偏小. 车最高 40km/h (115ms/脉冲) 不受影响.
> 要支持更高速度得让 ISR 自己算间隔并塞进环形队列.

### 车速冻在 19.6km/h (1.5.3 修) —— 毛刺闸门自锁

用户反馈"速度还是有概率冻结". 关键线索: **19.6 正好是 39.2 的一半**, 而这车最高 40km/h.
19.6km/h 对应真间隔 235ms, 40km/h 对应 115ms —— 比例正好 2 倍.

#### 根因: 门槛没有上限 → 丢掉真脉冲 → 间隔翻倍 → 门槛再涨 (自锁)

1.5.1 的自适应闸门: 门槛 = 最近一次可信间隔 × 60%, 用来挡"离真沿 50~60ms"那种振铃.
问题出在**这个门槛没有上限**:

1. 19.6km/h 时真间隔 235ms → 门槛 = 141ms
2. 一脚油门冲到 40km/h, 真间隔掉到 115ms. **115ms < 141ms → 第一个真脉冲被当成毛刺丢掉**
3. 关键: 丢毛刺时**不更新** last/prev 时间戳 (这是防毛刺劈开间隔的正确做法)
   → 所以下一个脉冲到来时, 距上次"被接受"的脉冲已经过了 230ms
   → **这一拍量到的间隔是 230ms, 真实值的两倍**
4. 230ms 进历史 → 参照量变成 230ms → 门槛 = 138ms
5. 真间隔 115ms 还是 < 138ms → 还是被丢 → 还是量到 230ms → **死循环**

车速于是永久锁死在真实值的**一半**: 骑 40km/h 显示 20km/h, 停下再起步才恢复.
这解释了为什么"有概率" —— 要一脚油门冲得够猛才触发, 平缓加速不会.

#### 修法: 门槛加**上限** (HALL_GATE_MAX_US = 80ms)

门槛 = clamp(参照量 × 60%, 25ms, 80ms).

- 40km/h 的真间隔是 115ms, **80ms 的上限谁也碰不到** → 真脉冲永远不会被误伤
  → 锁死从"可能发生"变成"结构上不可能" ✓
- 80ms 也高于实测的振铃偏移上限 (60ms) → 毛刺照样被挡 ✓
- 80ms 对应 1.28m 轮子的 57.6km/h, 这车最高 40km/h, 余量够

同时把参照量从"最近一次"改成"历史中位数": 最近一次会被毛刺带跑 (门槛越算越松 →
毛刺越放越进来); 最小值更糟 (一个毛刺就把门槛拉到 25ms 地板, 之后所有毛刺都进得来).
中位数天生抗离群值.

> **教训**: 这种"用测量值反馈去调阈值"的逻辑, 一定要检查**阈值有没有上限**.
> 反馈回路里一旦出现"越过滤越松/越紧"的自锁, 症状就是数值卡在一个固定值上,
> 而且越用越糟. 加一条上限比事后调参数管用.

#### 测速逻辑抽成头文件, 加了单元测试

测速的逻辑现在全在 `src/hall_speed.h` 里 (不依赖 Arduino), 固件直接用它.
`tools/test_hall_speed.cpp` 在 PC 上跑仿真, 里面**照抄了 1.5.2 的老逻辑**当对照组:

| 场景 (真实 40km/h) | 老逻辑 | 只加上限 | 新逻辑 |
|---|---|---|---|
| 19.6 → 40 猛加速 (0.5s) | **20.0** ← 复现了 bug | 40.0 ✓ | 40.0 ✓ |
| 19.6 → 40 慢慢加速 (8s) | 40.0 | 40.0 ✓ | 40.0 ✓ |
| 带振铃毛刺匀速 20 | 20.0 ✓ | 20.0 ✓ | 20.0 ✓ |
| 停车 → 起步 | 恢复 ✓ | 恢复 ✓ | 恢复 ✓ |
| 每 7 个漏 1 个脉冲 | 20.0 ✓ | 20.0 ✓ | 20.0 ✓ |

"只加上限"这一列证明**上限就是全部的修复**, 其它改动都是锦上添花.
⚠️ 以后改测速逻辑, 先跑 `bash tools/run_tests.sh` (第 2 组).

### 刚骑车车速飙到 100+km/h (1.5.4 修) —— 没有参照量时门槛太松

用户反馈"刚骑车是一百多的速度, 好像是十倍, 骑一会速度就正常了".

关键线索: **"十倍"**. 1.28m 的轮子, 间隔 10 倍短 = 车速 10 倍高 → 被当成真脉冲收下的
那个间隔, 只有真间隔的 1/10. 30ms 的振铃 → 1.28/0.030 = 153km/h ✓.

#### 根因: 参照量为 0 时, 门槛塌到下限

1.5.1~1.5.3 的门槛 = clamp(参照量 × 60%, 25ms, 80ms). 但**参照量 = 0 时** (刚开机,
或刚停车超过 3 秒 → 历史被清空 → 参照量清零), 门槛只剩 **25ms 下限** —— 太松了:

1. 车上振铃是"离真沿 3~60ms" (NOTES §7.4 记的实测范围)
2. 起步时没有参照量 → 门槛 25ms → **26~60ms 的振铃被当成真脉冲收下**
3. 那个 30ms 的间隔进历史 → 中位数被污染 → 车速 = 153km/h
4. 而且污染是**自持**的: 参照量被拉到 30ms → 门槛又只剩 25ms → 更多振铃进来

"骑一会就正常"是因为历史只有 5 个样本, 真间隔很快把坏样本挤出去了 —— 但刚起步那几秒是错的.

#### 修法: 没有参照量时用**保守**的门槛 (80ms), 不是宽松的下限

```cpp
if (ref == 0) min_ok = HALL_GATE_STARTUP_US;   // 80ms, 保守
else           min_ok = clamp(ref * 3/5, 25ms, 80ms);
```

80ms 的依据 (两条约束夹出来的):
- **> 振铃偏移上限 60ms** → 26~60ms 的振铃照样被挡 ✓
- **< 最低真实间隔 115ms** (40km/h) → 真脉冲不会被误伤 ✓

⚠️ 注意跟 `HALL_GATE_MAX_US` (也是 80ms) 是**两回事**:
- `HALL_GATE_MAX_US` 防的是"门槛涨到超过真间隔"的自锁 (车速冻在一半)
- `HALL_GATE_STARTUP_US` 防的是"没有参照量时门槛太松" (车速飙十倍)
数值相同纯属巧合, 所以分成两个常量, 以后调其中一个别动另一个.

#### 复现

`tools/test_hall_speed.cpp` 里照抄了 1.5.1/1.5.2 的老逻辑当对照组:

| 起步 1 秒内的最高显示 (真实 19.6 km/h) | 老逻辑 | 新逻辑 |
|---|---|---|
| 刚停车 → 起步 | **153.6 km/h** ← 复现了 bug | 19.6 ✓ |

### 车速下面那排的电压/电流是死的 (1.5.5 删掉)

用户反馈"速度下面的电压和电流现在是死的吧? 因为我看 bms 解析了, 电流也一直是 0,
如果和 bms 重复了就删除吧".

查下来确实是死的 —— 而且是**两处假数**:

| 位置 | 数据来源 | 实际显示 |
|---|---|---|
| 车速下面那排 "电压/电流" | `foc_status.voltage/.current` —— **初值写死 480/0, 从来没人改过** | 48.0 V / 0.0 A |
| 电池区 "总电压 / 电流" | BMS 报文真值 (`bms_info`) | 45.2 V / 真电流 |

所以那排显示的是**占位值**, 跟电池区里 BMS 解析出来的真值重复, 而且**还打架**
(48.0V vs 45.2V). 电流那更是永远 0.0 A (占位值), 而 BMS 那边其实有真电流
(0.1A 一档, 负数 = 回充).

> 注: 这两个字段**没有**进 485 应答帧 —— 发给 ECU 的 FOC 帧里那几个字节
> (`0x30 0x26 0x3C ...`) 是写死的常量, 跟 `foc_status.voltage/current` 无关.
> 所以动这两个字段不会影响车上的通信.

修法:

1. **小程序**: 车速下面那排删掉 "电压" "电流" 两格, 只留 转速 + 锁定状态
   (`flex: 1` 按格子数均分, 剩两格照样居中好看). 电池区的 BMS 真值保留.
2. **固件**: 遥测帧里那两个字节改成**填 BMS 的真值** (`bms_info.voltage_dv` /
   `bms_info.current`). 帧格式一个字没改 (还是 20 字节, 同样的偏移), 所以
   **老版本小程序照样能解析**, 只是这两个数从"假的"变成"真的" —— 不用等小程序更新.
3. **固件**: `FOCStatus` 里那两个字段删掉 (已经没人引用了). 留着的话
   以后肯定有人误用 —— 一看"voltage"就以为是真电压.

顺带说明: 电池区那个"总电压/电流"是**活的**, 电流为 0 只是因为车停着没放电.

### 电池趋势图 (1.5.1 加)

车辆页电池区加了 canvas 图 (`miniprogram/utils/chart.js`): 上块 电量 % (固定 0~100),
下块 总电压 V (自动缩放).

规矩 (照 dataviz 那套方法): **不搞双 Y 轴** (量纲不同, 交叉点没意义 → 拆成上下两块
小图, 各自一个纵轴); 每个面板一条线 → 不要图例; 线宽 2px, 网格弱化; 只标最新值;
文字用中性色; 配色用校验过的分类色 (深色: 电量 #3987e5, 电压 #199e70).

数据每 5 秒一个点、最多 120 个 (10 分钟). 用 canvas **老 API** ——
用户的微信基础库比较老, 新的 canvas 2D 接口 (要 2.9.0+) 用不了.

### 自测

`bash tools/run_tests.sh` —— 不用板子不用车. 含**跨语言还原**: 设备侧生成包 →
小程序端解析 → 跟原文逐字节一致.

**还没验证的**: 真机上的完整流程 (点"保存日志" → 拉到日志 → 存文件 → 分享到微信).

## 7. 已知问题 / 坑

| 问题 | 状态 | 备注 |
|---|---|---|
| 485 收不到任何报文 | ✅ 修 | 波特率 115200→9600, 8N1→8E1 |
| 回包地址错 (V35 拒收) | 🔄 2026-10 改回 | 真车 FOC 应答带的是**自己的**地址对 `20 DF` (BMS 回 `31 CE`、仪表回 `10 EF`), 之前用 `40 BF` 与真车不符, 已改回; 若 V35 实测要求 `40/BF`, 把 `REPLY_WITH_ECU_ADDR` 设 1 |
| Wire.cpp 开机错误刷屏 | ✅ 修 | Wire.begin 提前到 setup 顶部 |
| ESP-IDF log 刷屏 | ✅ 修 | `CORE_DEBUG_LEVEL=3` (编译期关 log_v/log_d) |
| 霍尔轮速乱跳 | ✅ 修 | 原来 `INPUT` 无上拉 → 改 `INPUT_PULLUP` |
| 霍尔磁钢盘安装 | ✅ 修 | 磁钢 1 个, 周长实测 1.28m; `USE_HALL_SPEED` 已置 1, 测速从"计数窗口"改成"脉冲间隔" (单磁钢下计数窗口会乱跳), 3s 无脉冲判停转 |
| 车速协议刻度错 | ✅ 修 | 原来是非线性表且封顶 31 (14.9 km/h), 实际是线性刻度 `round(kmh×25/12)`, 范围 0..127 (依据 xzfn ECU 源码 + 抓包) |
| 状态帧长度/字段错位 | ✅ 修 | 原厂 `0x02 05 08` 应答是 **12 字节**, 车速在**第 9 字节** (协议值 0-127, 线性刻度 kmh×25/12), 之前回 14 字节且把速度放在 [3][4], ECU 读不到车速还会报错误码 190 |
| GPIO2 占用 | ✅ 修 | strapping pin, 485 RX 挪到 GPIO4, TX 挪到 GPIO7 |
| **偶发没有车速** | 🔄 2026-10-28 改 | 协议侧逐字节核对过是对的 (见下面的"偶发没有车速"专项), 所以问题在测速和时序两处: ① 测速改成最近 5 个间隔取**中位数**, 漏一个脉冲不再让车速掉一半; 停转阈值 2s→3s, 2~3km/h 的蠕行不再整段显示 0. ② 485 应答路径去掉 `Serial.flush()` —— USB 接上电脑时 flush 最长阻塞 100ms, 而 V35 单次轮询超时只有 ~20ms, 卡一次这一轮就变成"没应答→错误码 190→车速 0". ③ 收到帧先校验和再决定要不要答, 噪声帧不再被当成查询. 另外加了诊断字段, 小程序上能直接看出是总线还是霍尔的问题 |
| **WiFi 连不上 + 屏幕一会亮一会不亮** | 🔄 2026-10-29 改 | 见 §7.2 专项. 根因是 OLED 画屏放在 `loop()` 里 (100kHz 下一屏 95ms), loop 被占掉 ~95% 的时间, 连带把 485 应答和 WebServer 一起饿死. 改法: 画屏挪到独立任务 + I2C 提到 400kHz; 热点信道 1→11 (避 BLE 广播信道 37); WiFi 发射功率降到 8.5dBm. 屏幕常驻显示 `rst:` 复位原因, 车上要是还在闪, 看这一行就知道是不是在反复复位 |
| BLE 防丢器自动解锁 | ❌ 已放弃 | 红米 Watch 3 广播窗口太短 + iPhone 侧无法配合, 实现不了, 已移除 |
| NFC (PN532) 无钥匙解锁 | ❌ 已移除 | 2026-10-22 删除驱动代码/接线文档/库依赖, I2C 只留板载 OLED |
| 485 FOC 解锁 CRC16 (poly 0x7085) | ❌ 未实现 | 真正的 FOC 解锁需要 CRC16 算 token, 现在只处理 0x01 unlock 命令立即返回成功 |
| OTA 通道 | ✅ 硬件实测通过 | 固件侧用 `tools/ota_push_test.sh` 推过好几次 (含 1.59MB 的 BLE 固件), 分区切换正常; 小程序真机行为还没实测 (这台机器没有微信开发者工具也没有 iPhone) |
| **`/ota/info` 一发就重启** | ✅ 2026-11-02 修 | `snprintf` 的参数跟格式串错位一格, `%s` 吃到了整数 `1` 当指针解引用 → Load access fault. 见 §6 的专项 |
| 485 分帧靠 0x16 找帧尾 | ✅ 修 | 数据区里也可能有 0x16 (明文 0xE3 + 0x33), 会把帧劈成两半 → 改成按长度字节定帧 (见 §6.6) |
| 电池 BMS 报文 | 🔄 待上车实测 | 解析器用真车抓包的 2041 帧 BMS 报文逐字段核对过 (100% 解析成功, 校验和 0 错); BLE 打包格式也跟小程序端对过; 但**装到车上抓真实 BMS 报文还没测** (板子当时没接在车上的 485 总线上) |
| BLE 断连后不广播 | ✅ 修 | 在 `onDisconnect` 回调里重启广播会被静默丢掉, 必须延后到主循环 (见 §6.5) |
| **iPhone 扫不到 NIU-U1-BLE** | ✅ 2026-10-30 修 | 见 §7.3 专项. **根因是 `wx.onBluetoothDevicesFound` 在用户手机的微信基础库版本里不存在** (2.11.0 才有, 老版只有单数的 `onBluetoothDeviceFound`) —— 扫描回调压根没注册上. 小程序改成三路兜底 + 加了基础库自检. 另外三个问题也一并修了: 广播包名字放主广播包 / 不传 `services` (iOS 上空数组会被当过滤条件) / 固件定期重启广播兜底. **用户实测 iPhone 已连上** |
| BLE 重连后单体电压/型号串不再推 | ✅ 修 | 这两条是"变了才推", 重连后手机状态是空的 → 断连时清哈希 (见 §6.5) |
| **车上蓝牙连不上 / 板子反复重启** | ✅ 2026-11-04 修 | 根因是 `bms_protocol.h` 解析 BMS 应答时**栈缓冲区越界** —— `plain[43]` 是照"目前观测到的最大帧"开的, 一字节余量都没有, 而 `dataLen` 直接取自总线帧内容、最大 255、没有任何上限检查 → BMS 回一帧更长的应答就写穿栈 → PANIC → 板子重启 → 蓝牙忽隐忽现、"连上约一秒就掉". **台架测不出来是因为台架没接 ECU, 总线上一帧 BMS 都没有, 这段代码一次都没执行过.** 见 §7.5 |
| **车速放大 ~40 倍 (真实 20 km/h → 小程序 800~1000 km/h)** | 🔄 2026-11-04 已定位已修 | 根因是 **ISR 消抖只有 1ms**, 车上传感器振铃/干扰产生的毛刺能穿过去, 一个毛刺把一个真间隔劈成两半, 毛刺占多数时 5 个样本的中位数变成毛刺值 (3ms) → 20000 RPM. 修法: 加 25ms 物理闸门 + 丢毛刺时不更新 last/prev. PC 仿真复现: 旧逻辑 1536 km/h → 新逻辑 20.0 km/h. 见 §7.4 待办 A |
| **中控五分钟后断电** | ❌ 待查 | 2026-11-04 上车反馈. 先分清是"中控断电"还是"FOC 掉电". 怀疑点是 ECU 问了几个我们**没回**的查询 (0x01 0x38/0x3C 现在是静默处理) 以及解锁 token 的 CRC16 没实现. 排查步骤见 §7.4 待办 B |
| iOS 本地网络权限 | ⚠️ 注意 | iOS 14+ 第一次连热点时微信会弹「本地网络」授权, 要点允许, 否则小程序发不出请求 |
| 安卓 BLE 扫描要定位权限 | ⚠️ 注意 | Android 6+ 扫蓝牙要「定位」权限, 不给就扫不到设备 |

### 7.1 "偶发没有车速" 的排查过程 (2026-10-28)

现象: 仪表 (和小程序) 偶发不显示车速, 别的实现 (glm5.2 的 FOC 模拟器) 却"跑起来没问题,
会有稳定的速度恢复". 先怀疑协议, 逐条核对后发现协议侧是对的:

**协议侧核对结论 (用 xzfn/scooter-repair 的真车抓包逐字节对)**

| V35 发给 FOC 的 | 原厂 FOC 回的 | 我们回的 | 一致? |
|---|---|---|---|
| `01 01` (状态标志) | `81 01 \| 00` (1 字节) | 同 | ✅ |
| `01 01 \| 02` (版本) | `81 10 \| "U1E02V11U1E02V11"` | 同 | ✅ |
| `01 01 \| 03` (MU 号) | `81 10 \| "MU13482B42510971"` | 同 (16 字节) | ✅ |
| `01 01 \| 04` (固件版本) | `81 01 \| 11` | 同 | ✅ |
| `05 02` (解锁 CRC16) | `85 01 \| ce` | 同 | ✅ |
| `06 01 \| 11` (周期配置, ~1.2s 一次) | `86 00` (空数据) | 同 | ✅ |
| `02 02 \| 05 08` (问车速, ~200ms 一次) | `82 0c \| 30 26 3c 01 00 19 00 00 00 00 08 00` | 同 | ✅ |

几个容易踩的点:

- **数据区是 ±0x33 混淆的**: V35 发的 `02 02 38 3b` 反混淆后才是 `05 08`;
  我们回的时候也要 +0x33 再发出去.
- **校验和是从帧头累加到 CS 前一字节取低 8 位** (不是 CRC):
  `68 20 df 68 82 0c 63 59 6f 34 33 4c 33 33 33 33 3b 33` 的 CS = 0x75 ✓ (我们的算法一致).
- **应答帧带的是自己的地址对** `20 DF`, 不是请求方的 `40 BF`.
- **12 字节状态帧里车速在第 9 个字节** (下标 9), 有符号 int8, 负数=倒挂;
  ECU 侧换算 `仪表速度 = 值×12/25`, 负值直接归零.
- **应答长度必须精确**: `05 08` 回 12 字节, `05 09` 回 14 字节, 长度不对 ECU 整帧丢弃.
- V35 的单次轮询超时只有 **~20ms** (真车抓包里从发问到收到应答稳定 21ms), 应答必须快.

既然协议是对的, 剩下的就是测速和时序 (见 §7 表格里"偶发没有车速"那一行).

**怎么在车上确认是哪一类问题**: 小程序"诊断"卡片 (固件 1.3.0 起)

| 现象 | 结论 |
|---|---|
| 轮询数一直涨, 应答数也涨, 但脉冲数不涨 | 霍尔/磁钢没信号 —— 车轮在转但传感器没出脉冲 |
| 轮询数涨, 应答数不涨 | 我们没答上 (校验和错误帧会累计) |
| 两个数都不涨 | 485 总线没通 (接线/地址/波特率) |
| 脉冲数在涨, 车速却是 0 | 磁钢位置/极性不对, 或者停转阈值判定错了 |

## 7.2 "WiFi 连不上 + 屏幕一会亮一会不亮" 的排查过程 (2026-10-29)

用户反馈: 刷了带 OTA 的固件之后, 手机连不上热点, 而且屏幕一会亮一会不亮.

**三个症状, 其实是同一个根因**: 加了 WiFi + BLE 之后固件从 320KB 涨到 1.58MB,
但真正的问题在 OLED —— 画屏一直放在 `loop()` 里, 而一屏 1024 字节在 I2C 100kHz 下要传 **95ms**.
于是 `loop()` 有 95% 的时间在画屏, 什么都干不了, 连带三个后果:

| 被饿死的东西 | 表现 |
|---|---|
| 485 收包 + 应答 | V35 单次轮询超时只有 ~20ms → 这一轮"没应答" → 错误码 190 + 车速 0 |
| `otaService.handle()` (WebServer) | 手机连上热点了, 但 HTTP 请求发不出去 → "wifi 连不上" |
| 屏幕内容 | 在"正常车速"和"错误码 190"之间来回变 → 看着就是**屏幕在闪** |

**改动 (固件 1.3.1)**:

1. **画屏挪到独立 FreeRTOS 任务** (`oledTask`, 优先级 1, 栈 4096, 周期 200ms).
   loop 每 100ms 只把快照写进 `disp_state` (互斥量保护), I2C 全在 OLED 任务里做.
   优先级跟 Arduino 的 loop 任务同级, 靠时间片轮转, 不会饿死应答.
2. **I2C 从 100kHz 提到 400kHz** (1024 字节 95ms → ~25ms), 并在 include u8g2 **之前**
   `#define U8X8_DO_NOT_SET_WIRE_CLOCK` —— 不然 u8g2 每传一页都会把时钟改回 100kHz.
3. **热点信道 1 → 11**: 默认信道 1 (2412MHz) 压在 BLE 广播信道 37 (2402MHz) 上,
   共存时手机能扫到热点但连不上/连上就掉. 信道 11 (2452MHz) 离三个 BLE 信道都最远.
4. **WiFi 发射功率 19.5dBm → 8.5dBm** + `WiFi.setSleep(false)`:
   手机就贴在车边, 功率再高没用; 满功率发射瞬时电流 300mA+, 车上是 48V 降压供电,
   功率小了不容易棕断 (棕断 = 反复重启 = 热点掉线 + 屏幕闪, 一个根因两个症状).
5. **屏幕常驻显示 `rst:<复位原因>`** (开机画面里也显示): 上次是 POWERON / SW / PANIC /
   TASK_WDT / BROWNOUT. 车上要是还在闪, 这一行直接告诉你是不是在反复复位.

**台架验证** (模拟 V35 每 200ms 发一帧, 显示满负荷重画): 60/60 应答,
延迟最小 36.6ms / 中位 38.0ms / 最大 44.3ms —— 与显示空闲时一致, 说明画屏已经不占应答路径了.

**还没验证的**: 这台机器的无线网卡扫不到 2.4GHz (只扫得到 5GHz), 也没有 iPhone,
所以 **SoftAP 的真实可连性没法在台架上测**, 只能上车试.
上车时按这个顺序看:

1. 屏幕上的 `rst:` 是不是 PANIC / BROWNOUT —— 是的话是反复复位, 先查供电
2. 手机能不能**列出** `NIU-U1-OTA` 这个热点 —— 列不出 = 信号/供电/信道问题
   (蓝牙那边是 `NIU-U1-BLE`, 两个名字不一样, 别找错)
3. 列得出但连不上 = 信道或共存问题
4. 连上了但小程序连不上 → 看小程序日志, 它会提示 iOS 本地网络权限 / 域名白名单
5. 插上 USB 看串口里的 `[AP] ... 客户端:N` —— N 一直是 0 就是压根没关联上

## 7.3 "iPhone 扫不到 NIU-U1-BLE" 的排查过程 (2026-10-30, ✅ 已解决)

用户反馈: 用小程序升级完固件之后, iPhone 的蓝牙列表里**看不到** NIU-U1-BLE,
只能看到别的设备 (TCL 电视). 小程序的报错也没变化.

**最终结论: 是微信小程序端的一行 API 在用户手机上不存在, 跟固件的广播包没关系.**

```
wx.onBluetoothDevicesFound is not a function
```

`wx.onBluetoothDevicesFound` 是**基础库 2.11.0 才加的**, 更老的微信只有**单数**的
`wx.onBluetoothDeviceFound`. 用户手机上这个 API 压根不存在 → **扫描回调没注册上** →
`wx.startBluetoothDevicesDiscovery` 扫是扫了, 但**没人接收结果**, 所以永远扫不到.

**在这种情况下, 固件的广播包长什么样完全不影响结果** —— 前面几轮改广播布局、
放宽广播间隔、甚至改架构 (WiFi 默认关), 都不是卡住的那一环. 排查方向从一开始就偏了.

> **教训**: 排查「手机上功能不工作」时, **先确认手机端那段代码真的跑到了**,
> 再去查设备/固件侧. 让用户贴**原始报错原文**, 不要只看「功能不工作」的描述.

**修法 (小程序 1.4.2)**:

| 情况 | 用哪个 |
|---|---|
| 有 `wx.onBluetoothDevicesFound` (2.11.0+) | 用它 (新版, 一次给一批设备) |
| 只有 `wx.onBluetoothDeviceFound` (老版) | 用它, 但回调参数是**单个设备**不是数组, 要包一层 |
| 都不靠谱 | 兜底: 每 1.5 秒 `wx.getBluetoothDevices` 拉一次已知设备列表 |

配套:
- 点「连接」前先跑 `ble.missingApis()` 自检, 缺哪些 API 直接列出来 (而不是抛 is not a function)
- `wx.onBLECharacteristicValueChange` 也加 typeof 检查, 缺了弹「微信版本太老」
- `project.config.json` 的 `libVersion` 从 **3.0.0** (2021年的) 提到 **3.7.12**

**结果: 用户实测 iPhone 蓝牙连上了** ✅ (小程序 1.4.2)

### 排查过程中一并发现并修掉的另外三个问题

这三个不是根因, 但都是真问题, 留着以后还会咬人:

**1. 广播包布局: 名字必须放主广播包**

蓝牙分两种扫描:
- **主动扫描**: 手机发 SCAN_REQ, 外设回 SCAN_RSP —— 能拿到扫描回应里的内容
- **被动扫描**: 手机只听广播包 (ADV_IND) —— **扫描回应里的东西一概收不到**

Arduino BLE 库的默认布局是「主广播包只放 Flags, 名字和 UUID 全塞扫描回应」.
Linux 的 `bluetoothctl` 用主动扫描, 所以一直看得到 —— **台架上测不出这个坑**.
而 iPhone 上微信小程序在后台用的是被动扫描, 拿到的只有 Flags 没有名字,
按名字前缀 `NIU-U1` 一过滤就把它扔了.

改法 (固件 1.4.0): 自定义 `BLEAdvertisementData` ——
主广播包 = Flags(0x06) + 完整设备名; 扫描回应 = 名字 + 128 位 UUID.
注意 31 字节上限: Flags(3)+名字(12)+UUID(18)=33 **超了会被静默丢弃**,
所以扫描回应里**不放 Flags**, 刚好 30 字节.

**2. 小程序在 iOS 上不能传 `services: []`**

微信文档说 `services` 是"要搜索的广播包里有对应 UUID 的主服务的设备".
iOS 的实现里, **传空数组被当成"过滤条件存在"**, 结果只上报广播里带服务 UUID 的设备.
我们主广播包只有 Flags + 名字, 128 位 UUID 在扫描回应里 —— **正好被这个过滤挡掉**.
安卓的语义不同, 所以安卓能扫到、iPhone 扫不到.

改法: **小程序侧干脆不传 `services`**, 扫到全部再在 JS 里按名字前缀筛.

**3. 固件可能进入"活着但不广播"的状态**

BLE 的重新广播有坑: `advertising->start()` 有可能正好撞上 GAP 状态机没准备好而被**静默丢掉**
(代码却以为成功了). 一旦这样, 板子活着、485 正常、WiFi 正常, 但**BLE 再也不广播**,
手机永远扫不到 —— 而且这个状态在车上没法自查.

改法 (固件 1.4.1): **定期重启广播** (没连手机时每 15 秒一次, `BLE_REBROADCAST_PERIOD_MS`),
保证广播一定活着. 串口会打 `[BLE] 广播重启 (定期兜底)`.

### 排查过程中做过的验证

**第一步: 确认板子本身正常.** 台架上 `bluetoothctl` 能扫到 `NIU-U1-BLE` (RSSI -44 ~ -52dBm),
`bluetoothctl connect` 也能连上, 四个特征 + 2902 描述符都在. 所以**固件和手机之间的射频没问题**.

**第二步: 读 flash 确认跑的是哪版固件.** `esptool read_flash` 把两个槽都读出来对比:

- app0 (0x10000): 版本串 `1.3.1`
- app1 (0x1E0000): 版本串 `1.3.2`, 头 16KB 与小程序包里的固件**逐字节相同**
  (说明 OTA 确实写进去了)

app0 与 1.3.2 的包整包只差 **66 个字节** (32 字节编译哈希 + 版本号 3 个字符 + 尾部哈希),
也就是说**代码完全一样** —— 1.3.1 那次构建就已经包含了广播布局的改动. OTA 生效了.

**第三步: 看广播包到底长什么样.** `btmon` 抓 HCI:

```
LE Advertising Report (0x02)
  Event type: Connectable undirected - ADV_IND (0x00)
  Address: E8:3D:C1:8D:D4:06
  Data length: 15
  Flags: 0x06
  Name (complete): NIU-U1-BLE
```

名字在包里的 —— 所以射频和固件都没问题, 只能是手机端.

**iPhone 能看到笔记本的 BLE (`wangxuhui-QTC6`) 却看不到我们的** ——
这说明**手机蓝牙接收本身没问题**, 缩小了范围. (不过最终根因还是手机端 API, 与射频无关.)

**iOS 对同一设备地址的 GATT 缓存很顽固** —— 之前连接失败过的话, 之后可能一直连不上.
所以小程序报错时会列出**扫到的每个设备**(名字/MAC/RSSI/UUID)和**微信缓存里的设备**
(`wx.getBluetoothDevices`), 这两项能直接区分各种 iOS 特有失败.

### 一个自己踩的坑: 用 btmon 的次数下结论会错

中途 btmon 显示"ESP32 16 秒才广播一次" (14.3s / 30.3s / 46.3s / 62.3s 各一次),
一度以为是共存调度限流, 还据此改了架构.
用 `hcitool lescan --duplicates` 抓**原始**广播包才看明白:

| 状态 | 12 秒内广播包数 | 折算 |
|---|---|---|
| WiFi 关 | 100 | ~8.3/秒 |
| WiFi 开 | 117 | ~9.75/秒 |
| WiFi 开 + 有客户端在线 | 117 | ~9.75/秒 |

**广播一直正常.** btmon 抓的是控制器**重复过滤之后**的上报, 那个"16 秒"是过滤器的假象.
(查共存问题必须用 `hcitool lescan --duplicates`, 要 root 且先停 bluetoothd.)

### 台架已验证

- 广播包内容用 btmon 核对过 (主广播包带完整名字 + Flags, 扫描回应带名字 + 128 位 UUID)
- BLE 开/关热点命令通路打通 (`0x57` 开 / `0x58` 关)
- 开→关→开→关 循环 4 次无 panic 无复位
- 定期重启广播生效 (每 15 秒一次)

### 还没验证的

HTTP 端到端 (本机无线网卡扫不到 2.4GHz, 连不上 ESP32 热点) —— 需用户用小程序实测.

上车后按这个顺序看:

1. 微信 → 小程序 → 车辆状态页, 点连接 (✅ 已验证可用)
2. 固件升级页 → 点「用蓝牙开热点」, 看热点能不能起来 (串口会打 `[OTA] 热点 ... 已启动`)
3. 推完固件板子自动重启, WiFi 回到默认关

### 7.4 上车待办 (2026-11-04 新增)

> 这两条是 2026-11-04 开车实测发现的, 写清楚现象和排查方向, 免得过两天忘了当时怎么想的。

#### 待办 A: 车速大 40 倍 (真实 ~20 km/h → 小程序显示 800~1000 km/h) — 🔄 已定位已修, 待上车复测

**现象**: 实际骑 20 km/h, 模拟器小程序显示 800~1000 km/h, 数量级完全不对 (虚高约 40 倍)。

**已排除的**: 协议换算那条路。协议车速值 `round(kmh×25/12)` 封顶 127 = 60.9 km/h, 仪表根本显示不出 800+,
所以错的是**内部 kmh 计算**, 不是 485 帧里那个字节。

**先算一遍期望值 (对照着看, 别凭感觉)**:

| 量 | 真实 20 km/h 时应该是 | 固件现在显示 800~1000 km/h 时相当于 |
|---|---|---|
| 轮速 RPM | `20 * 1000 / (1.28 * 60)` ≈ **260 RPM** | ≈ 10000 RPM |
| 脉冲周期 (1 磁钢) | 60/260 ≈ **230 ms** | ≈ **6 ms** |
| 脉冲频率 | ≈ 4.3 Hz | ≈ 170 Hz |

→ 所以固件是**以为脉冲每 ~6ms 就来一个**。

**已定位 (2026-11-04)**: 代码里的公式和常量全是对的 (`rpm = 60/(间隔秒数 × MAGNET_COUNT)`,
`MAGNET_COUNT=1`, `WHEEL_CIRCUMFERENCE_M=1.28`, `HALL_HISTORY=5` 取中位数)。**唯一的漏洞在 ISR 的消抖**:
`HALL_DEBOUNCE_US` 只有 **1ms**, 而车上 485 和电机控制器是强干扰源, 传感器开漏输出用内部 45k 上拉走长线,
**边沿振铃/毛刺完全能通过 1ms 闸门**。一个毛刺会把一个真间隔劈成"几毫秒 + 剩下的"两半:
短的进中位数历史、长的比真实值大 —— 毛刺占多数时中位数直接变成毛刺值 → 转速离谱。

**PC 上仿真复现 (忠实复刻 ISR + 中位数逻辑: 每 230ms 一个真脉冲, 每个真脉冲后 3ms/6ms 各跟一个毛刺)**:

| | 脉冲计数 | 算转速用的间隔 | 转速 | 车速 |
|---|---|---|---|---|
| 旧逻辑 (无毛刺闸门) | 39 (13 真 + 26 毛刺) | 3 ms | 20000 RPM | **1536 km/h** |
| 新逻辑 (25ms 闸门) | 13 (只有真的) | 230 ms | 261 RPM | **20.0 km/h** ✓ |

→ 旧逻辑算出来的 1536 km/h 跟车上看到的 800~1000 km/h 是同一量级, **假设成立**。

**修法 (固件 1.4.4)**:

1. **毛刺闸门**: `HALL_MIN_INTERVAL_US = 25000` (25ms)。1 磁钢 + 1.28m 轮子, 30km/h 时真实间隔 154ms、
   60km/h 时 77ms —— 25ms 对应 ~92km/h, 真实脉冲永远不可能落在这个区间, 落进来的只能是毛刺。
2. **关键: 丢弃毛刺时不更新 `last_pulse_us` / `prev_pulse_us`**。更新了的话一个毛刺会把真间隔劈成两半,
   短的进历史、长的也错; 不更新, 下一个**真**脉冲算出来的间隔才是准的。
3. 毛刺单独计数, 走 BLE 遥测的**字节 11** (原来放的是没人读的 flags; 不动 20 字节的帧长 —— 加到 24 字节
   在协商不出 MTU 的手机上会直接发不出去, 整条遥测就断了)。
4. 串口 `[状态]` 行现在同时打**最近间隔**和**中位间隔**, 以及毛刺计数 —— 转速用的是中位数, 小程序显示的是
   最近间隔, 这两个数对不上就是中位数被污染的铁证。

**上车复测 (刷 1.4.4 之后)**:

- [ ] 小程序「车辆」页展开**诊断**卡片, 骑 20 km/h: `间隔` 应该 ≈ 230ms, `转速` ≈ 260 RPM, `车速` ≈ 20 km/h
- [ ] **手动把轮子转整整一圈**, 看 `脉冲数` 涨了几个 —— 涨 1 = 硬件正常; 涨很多 = 磁钢不止一颗, 要改 `MAGNET_COUNT`
- [ ] 看 `毛刺` 计数: 一直涨 = 传感器振铃/线受干扰, 要加硬件滤波 (外挂 4.7k~10k 上拉 + 100nF 到 GND);
      一直是 0 但车速还是偏大 = 磁钢数不对
- [ ] 如果毛刺压不住, 把 `HALL_MIN_INTERVAL_US` 提到 50000 (对应 ~46km/h)

**✅ 上车复测结果 (2026-11-05, 固件 1.5.1): 车速跳变没了**

1.4.4 的 25ms 绝对闸门只挡住了 6ms 那种特别快的振铃. 1.4.4 刷上去以后,
用户还是反馈"速度有时候会跳变, 但匀速骑一会就准了, 车最高 40km/h".

分析: 骑车时真间隔是几百毫秒 (40km/h → 115ms), **50~60ms 的振铃照样穿得过去** →
混进中位数历史 → 车速跳来跳去; 匀速骑一会, 中位数收敛掉了那些坏样本 → 又准了.
**这跟"往上跳"的现象完全对得上** (多出来的脉冲 = 间隔变小 = 车速变大).

1.5.1 加了**自适应**闸门 (拿最近一次可信间隔当参照, 比它短 40% 以上的判为毛刺),
用户实测确认: **跳变没有了** ✓.

→ 结论: 跳的是**往上** (多出来的振铃脉冲), 不是漏脉冲. 所以没有加"间隔比中位数大很多
就丢弃"那条规则 (它在急刹时容易误杀).

> **顺带记一笔**: 有人建议"改用 PCNT 硬件计数 + 硬件毛刺滤波"、"改用固定窗口数脉冲"、
> "上 WiFi 冲突" 三条. 在这套硬件上都不成立或用不上:
>   - 脉冲频率只有 8.7Hz (40km/h), 中断一秒才 8.7 次, "CPU 忙于中断"不存在
>   - 我们的干扰是"离真沿 3~60ms"的脉冲, 硬件滤波窗口要开 ~10ms 才有意义
>     (建议里的"几微秒"比现有的 1ms 软件消抖还细, 换过去等于放宽过滤)
>   - PCNT 给的是计数不是周期, 8.7Hz 的信号按窗口数脉冲没法用 (100ms 窗口 0 或 1 个)
>   - 平时热点是关的, 没有 WiFi 任务在抢 CPU
>   - 我们取的是**最近 5 个间隔的中位数**, 不是"每个脉冲算一次瞬时速度"
> **教训: 滤波输入 (把坏样本挡在历史外) 比滤波输出 (把坏样本摊开平滑) 靠谱.**

#### 待办 B: 中控五分钟后断电

**现象**: 中控 (V35) 开机后约 5 分钟断电。

**先分清是哪种断电** (这决定了往哪个方向查):

- [ ] 是**中控自己黑屏/熄火**, 还是**中控给 FOC 的电断了** (板子掉电)?
      判据: 断电瞬间板子的 OLED 屏幕还亮不亮、还打不打 `[状态]` 日志。
      板子跟着一起断 = 供电问题 (中控切断了 FOC 供电线); 板子还活着 = 中控自己的策略 (熄屏/超时休眠)
- [ ] 断电是**一次性的**还是**周期性的** (每 5 分钟断一次, 重新上电又 5 分钟)?
- [ ] 断电前固件串口有没有异常 (复位 → OLED 上的 `rst:` 那行会写原因)

**怀疑点**:

1. **ECU 有"心跳/保活"要求, 我们没满足**。已知真车抓包里 V35 会周期性问 FOC, 包括
   `06 01 | 11` (周期配置, **~1.2s 一次**)。我们现在对 `0x06` 只回**空数据 ACK**。
   如果 ECU 期望 FOC 周期性地主动回某种帧 (而不只是被动应答), 5 分钟后它就会认为 FOC 掉线 → 断电。
   → 抓一段完整的上车总线流量 (`od -A x -t x1 /dev/ttyUSB0` 旁路串口工具, 见 §8),
     看断电前最后几秒 ECU 到底在问什么、我们在答什么。
2. **某个查询我们答错了/没答, ECU 判定通信失败**。已知的可疑点:
   - `0x01` 控制帧的 `0x38` (读 FOC 额定电压) 和 `0x3C` (读额定电流) 现在是**静默处理** (不回),
     真车 FOC 是会回的 (见 §3 的 `FOC read voltage` / `FOC read current` 示例帧)
   - `0x04` 写数据 / `0x05` 设置参数 我们只回固定 ACK, 不看内容
   - 解锁 `0x01 0x03` 我们直接回成功, **没有实现真车的 CRC16 token** (poly 0x7085, 见 §7 表格)
     → ECU 可能需要正确的 token 才继续供电/解锁
3. **中控自己的超时熄屏策略**。有些中控在"检测不到有效骑行/无操作"若干分钟后主动断电, 与 FOC 无关。
   → 查 V35 中控是不是本来就有这个行为 (对比真车: 原厂 FOC 在车上放 5 分钟会不会也断)

**怎么查**:

- [ ] 先按上面的清单分清"谁断的电", 把结论写回这一节
- [ ] 打开固件的 `DEBUG_485_ECHO`, 串口全程留档, 定位断电前最后一帧
- [ ] 统计 `q_count` (收到查询次数) 与 `a_count` (回出应答次数) —— **两者必须相等**,
      不相等说明有查询我们漏答了 (小程序诊断区直接看这两个数)
- [ ] 用 `od -A x -t x1 /dev/ttyUSB0` 旁路抓一段上车总线流量, 对比真车抓包逐帧核对
- [ ] 把 `0x38` / `0x3C` 改成正常应答 (先照 §3 的示例帧格式猜一个, 再用抓包核对)
- [ ] 确认解锁是否真的需要 CRC16 token (参考 xzfn/scooter-repair 的实现), 需要就补上

### 7.5 "车上蓝牙连不上 / 板子反复重启" 的排查过程 (2026-11-04, ✅ 已解决)

现象: 装车后手机蓝牙列表里 `NIU-U1-BLE` **忽隐忽现**, 偶尔能连上约一秒就掉, 屏幕有时不亮。
台架用 12V/24V 电源接 XL7015 时一切正常 —— 一装车就废。

**根因: BMS 应答解析的栈越界, 板子反复 PANIC 重启。**

`src/bms_protocol.h` 解析 BMS 应答那几行 (改前):

```c
uint8_t dataLen = raw[5];                      // 来自总线帧内容, 最大 255
if ((size_t)dataLen + 8 != len) return false;  // 只校验了"长度字段和帧长对得上"
uint8_t plain[BMS_INFO_LEN];                   // 43 字节的栈缓冲区
for (uint8_t i = 0; i < dataLen; i++) {
    plain[i] = (uint8_t)(raw[6 + i] - 0x33);   // ← dataLen 可以到 255, 直接写穿栈
}
```

`plain` 是照着**目前观测到的最大帧** (43 字节) 开的, 一字节余量都没有; 而 `dataLen` 没有任何上限检查。
BMS 只要回一帧数据区 > 43 字节的应答 (或者一帧凑巧过了校验和的噪声帧), `plain[i]` 就**写穿栈**,
踩坏相邻的栈数据 → **PANIC → 板子重启**。

写穿栈的后果正好对上症状: 板子每次起来广播几十秒, 手机扫到就连上, 然后板子又掉电 →
"连上一秒就掉" + 列表里忽隐忽现 + 屏幕不亮。

**为什么台架测不出来**: 台架**没接 ECU**, 485 总线上一帧 BMS 都没有, 这段代码**一次都没执行过**。
装车后 ECU/BMS 一开口, 它才第一次跑。这是"台架条件 ≠ 车上条件"的典型翻车。

**修法**:

| | 改前 | 改后 |
|---|---|---|
| 缓冲区 | `uint8_t plain[BMS_INFO_LEN]` (43) | `uint8_t plain[BMS_MAX_DATA_LEN]` (64) |
| 长度检查 | 只查"字段和帧长对得上" | 追加 `if (dataLen > BMS_MAX_DATA_LEN) return false;` |

ASan 实证 (同一份测试跑改前改后两份代码):

- 改前: `stack-buffer-overflow`, `WRITE of size 1`, `'plain' overflows this variable`
- 改后: 丢帧返回 false, 无越界

**验证**: 刷 1.4.3 上车, 蓝牙恢复正常。

**教训 (比这个 bug 本身值钱)**:

1. **凡是"接了真实总线才会第一次执行"的代码路径, 台架必须用真车抓包喂一遍。** 只用模拟器喂的帧
   覆盖不到真实 ECU/BMS 的各种应答长度 —— 模拟器喂的都是"已知正确长度"的帧, 越界的那一帧永远喂不到。
2. **按"当前观测到的最大值"开的缓冲区是定时炸弹** —— 换个 BMS 固件、V35 多问一种查询, 长度就变了。
   长度字段来自外部数据, 必须显式跟缓冲区大小比一次, 不能靠"现在还没超"。
3. **"台架正常"这句话, 要追问一句"台架跟车上差在哪"**: 供电电压 (12V vs 48V)、总线 (没接 vs 接着)、
   测点位置。这次三条全差, 每一个都能单独藏一个 bug。
4. 屏幕常驻的 `rst:` 那行 (§7.2 加的) 在这次里就是定性用的 —— PANIC 和 BROWNOUT 的排查方向完全不同,
   有这行能省掉一轮瞎猜。**排查功能异常先看固件有没有把状态显示出来。**

供电那条线**没有完全排除**, 只是证明它不是本次的原因: XL7015 在 48V 下的输入耐压
(输入电解常配 35V/50V、续流肖特基常配 SS34/40V) 仍是隐患, 建议照飞书文档 §3.4 的加固清单改一遍。

## 8. 调试技巧

- **看 485 收**: loop() 里 `[485←]` 逐字节回显, 帧尾 0x16 换行
- **看 485 发**: `sendFrame()` 里 `[485→]` 回显整帧
- **看轮速**: `foc_status.wheel_rpm` / `wheel_speed_dm` (十分位整数), OLED 上直接显示
- **看状态**: `[状态] 已解锁 | 轮速:xxRPM | x.xkm/h` 每 3 秒一次
- **看电池**: `[BMS] 53.3V  0A  电量 100%  温度 30/30/30/30/29  单体 13 串 4.088~4.114V` 每秒一次
- **没车也想验 BMS 解析**: 串口里敲 `[TX] 68 31 CE 68 82 0F ... 16` 回车, 字节直接喂进 485 解析链路 (见 §6.6)
- **想看 485 完整原始帧**: `od -A x -t x1 /dev/ttyUSB0` 旁路串口工具 (需要 USB-485 转换器)

## 9. 关键文件位置

| 文件 | 作用 |
|---|---|
| `src/niu_u1_foc_simulator.ino` | 主程序, 唯一 .ino |
| `src/ota_config.h` | OTA 配置: SSID / 密码 / IP / 端口 / 分块大小 / 固件版本号 / 固件大小上限 / `OTA_AP_DEFAULT_OFF` |
| `src/ota_server.h` | OTA 服务端 (header-only): SoftAP + HTTP `/ota/*` + base64 解码 + 热点开关 |
| `src/ble_config.h` | BLE 配置: 设备名 / Service / 特征 UUID (含命令特征 `6e400005`) / 推送周期 |
| `src/ble_telemetry.h` | BLE 遥测服务 (header-only): GATT 服务 + 通知 + 断连后重新广播 + 热点遥控命令 |
| `src/ble_battery_msg.h` | 电池信息的 BLE 打包格式 (纯 C++, 可在 PC 上编译跑测试) |
| `src/bms_protocol.h` | 电池 BMS 报文解析 (纯 C++, 可在 PC 上编译跑测试) |
| `platformio.ini` | build flags: CORE_DEBUG_LEVEL=3, flash_size=4MB, CDC_ON_BOOT=1 |
| `partitions.csv` | 4MB flash 分区表 (A/B 双槽, 每槽 1.75MB) |
| `../tools/flash.sh` | 刷机脚本 (擦 otadata + bootloader + 分区表 + app) |
| `../tools/build_ota.sh` | 编译固件 + 压缩 + 打成小程序的 `firmware.js` |
| `../tools/lz_pack.py` | 固件压缩 (极简 LZ77, 配套 `miniprogram/utils/lz.js`) |
| `../tools/ota_push_test.sh` | curl 模拟小程序的端到端 OTA 测试 |
| `../tools/ota_open_ap.sh` | 蓝牙开热点 + 电脑连上去 (OTA 测试前置) |
| `../tools/upload_miniprogram.sh` | miniprogram-ci 上传 / 生成预览二维码 |
| `../miniprogram/` | 微信小程序源码 (`utils/bleLink.js` 是全局蓝牙连接单例) |

## 10. 引用资料

- [B 站: 小牛 V35 中控专用协议总结](https://www.bilibili.com/read/cv39475428) — 帧格式 / 校验和 / 7 条示例帧
- [GitHub: xzfn/scooter-repair](https://github.com/xzfn/scooter-repair) — 用 CH32V003 替代 V35 ECU, 含 FOC 解锁 CRC16 (poly 0x7085)
- [SMZDM: 开源救活 11 年老小牛](https://post.smzdm.com/p/a3mdqg4r/) — 海外/公司网络可能打不开, 国内可访问
