MrWANGXUHUI/niu-u1-foc-simulator/docs/video_prompt.md

# 小牛 U1 485 网络 + FOC 模拟器 — AI 视频生成提示词

> 用法：直接复制「主提示词」喂给 Sora / Veo / Kling / Runway 等视频生成工具。
> 「旁白文案」单独拿去配音（TTS 或人声），「后期字幕清单」在剪辑软件里加。

---

## ⚠️ 生成前必读

AI 视频模型**几乎无法正确渲染汉字和数字**——帧格式里的 `0x68`、`0x40 BF`、地址对、
速度值都会变成乱码。所以：

1. **不要让 AI 生成任何文字、数字、仪表盘、屏幕 UI**。提示词里已刻意规避。
2. 所有技术标注一律**后期在剪辑软件里加**（见「后期字幕清单」）。
3. **分段生成再拼接**：一次生成 90 秒会崩。每个镜头单独生成 5-8 秒，剪辑时串起来。
4. **保持零件一致性**：先用参考图（你的实拍照片）做 image reference / character reference，
   每个镜头都挂同一张，否则线和模块的造型会飘。
5. 视频生成不擅长"数据流动"的抽象概念，用**发光粒子沿导线流动**这种具象表现，别写"数据流"。
6. **同一个人的手要一致**：飞线、插充电口、装磁钢盘几个镜头建议用同一张手部参考图。

---

## 故事线（写提示词时对照这个因果链）

```
2G 退网  →  小牛强制更换 4G 版 V35NB 中控  →  换完出故障
                                             ↓
        ┌────────────────────────────────────┴────────────────────┐
        ↓                                                          ↓
  问题一：上电即查 FOC 轮速，                  问题二：GPS 只在锁车/开锁
  问不到 → 判定静止 → 5 分钟后断电            那一下定位，骑行中全程不定位
        └────────────────────────────────────┬────────────────────┘
                                             ↓
                                    根因：没有轮速
                                ECU 不知道车在动 → 不开 GPS
                                             ↓
                              自己造一个 FOC 控制器
                                             ↓
                    飞线接 485 → 并线到充电口 → 插 ESP32 模拟器
                                             ↓
        轮速有了 → ECU 知道车在动 → GPS 常开 → 电量显示 / 里程统计 全部恢复
```

---

## 主提示词（复制这段）

```
技术纪实风格的工程解说短片，16:9 横屏，4K，深色科技感配色。
整体色调偏冷蓝，发光描边用青色和橙色点缀。镜头运动缓慢稳定，浅景深，
真实拍摄的电动车部件保留金属、塑料、线束、灰尘的真实质感。

【镜头 1 · 时代背景】黄昏，一辆白色电动踏板车侧停在老旧居民楼的通道里，
车身有些年头，漆面微微发暗。楼上窗户亮着零星灯光。
画面右侧叠化进一个抽象画面：一座通信基站的剪影，
从塔顶向外扩散的同心圆信号波纹一圈圈变淡、消散、最终完全消失。
信号波纹消失的瞬间，画面整体轻微闪一下。

【镜头 2 · 老车与仪表】仪表盘特写。
老式仪表屏亮着，右上角有一个小小的信号图标，
图标上的信号格正在逐格消失，最后变成一个打叉的标记。
屏幕闪一下，重启后进入一个崭新的、深色主题的新界面。
镜头拉开，露出嵌在车把中央的中控面板。

【镜头 3 · 换中控】工作台特写。
一双戴着薄手套的手，把老中控面板的插头从车架线束里拔出来，
再把一个崭新的、表面更平整的中控面板插进同一个位置。
新面板边缘还贴着出厂保护膜。
镜头微微后拉，能看到桌上还摆着旧面板和几个螺丝。

【镜头 4 · 485 网络拓扑】画面转为深色三维技术动画。
一辆电动车的线束骨架悬浮在黑色背景里，几束发光的双绞线（青蓝色）
把四个方块模块连成一个星形网络。中心最大的方块是车把中央的中控面板，
其余三个方块分别是仪表、电机控制器、电池包。
每个方块边缘有一圈发光描边，双绞线里有细小的橙色光点沿着流动，
像电流一样从中心方块向外扩散，再逐个点亮外围方块。
镜头缓慢绕着这个网络旋转，展示全貌。

【镜头 5 · 报文】画面切成一段抽象的"数据流"特写。
一串发光的方块状字节（不显示任何字符，只有色块和数字形状的抽象图形）
沿着一条水平的光轨匀速滑过，轨道首尾各有一道更亮的门框状光标。
光标扫过时字节阵列停顿一下，然后继续滑动。
镜头微微推近，画面边缘有数据流过时的拖影。

【镜头 6 · 故障一：断电】切回实拍。一辆较旧的电动踏板车被推到修理铺的工作台上，
台面上摊着拆开的零件、螺丝刀、万用表。
一个成年人骑上车，用力拧动转把，车轮转了几圈，
然后仪表屏整个暗下去，车灯熄灭，人从车上下来，一脸困惑。
镜头从拧转把的手部特写缓慢上移到他的侧脸。
色调偏冷，阴影加深。

【镜头 7 · 故障二：GPS 飘移】手机屏幕特写，竖握。
屏幕是一块深色底、没有任何文字和地名标签的抽象地图表现，
只有几条隐约的道路线条。
一只手指在屏幕上点了一下，屏幕亮起，地图上出现一个发光的定位光点，
光点稳定地闪了两下——随即整个屏幕又暗下去，光点消失。
镜头后拉，露出背景里正在行驶的电动车（虚焦）。
暗示：只有锁车、开锁那一下才定位，骑行途中全程没有定位。

【镜头 8 · 飞线】工作台特写。
一只手把两根本来没有的细导线（红色和黑色）从中控面板背面的接线端子，
引到车架里一块电池包的接线柱上，拧紧。
导线接好后，镜头拉远，能看到这根新加的线绕过车架走线。
这段新线在后期会被高亮标注。

【镜头 9 · 充电口】车头下方一个打开的防水橡胶盖，
盖子里有一个带多针孔的圆形充电插座。
一只手把一个小小的转接板插进这个插座，
转接板上一片黑色芯片、一颗蓝色电解电容、几根细线清晰可见。
镜头从插座缓缓推进到转接板芯片上，芯片表面有微弱的反光。

【镜头 10 · 轮速采集】车轮特写，轮胎缓慢转动。
轮辋内侧固定着一块小小的电路板（霍尔传感器），
旁边吸附着一个圆形的黑色多极磁钢盘，磁钢盘随车轮同步旋转。
每次磁钢经过传感器，传感器上那颗小小的黑色芯片就闪一下微弱的青光。
一圈六次，节奏均匀。

【镜头 11 · 数据回到中控】画面回到三维技术动画。
霍尔传感器发出的青色脉冲方波沿着导线流向一块蓝色的小模块，
模块上跳出一个数字化的速度条，数字条被编码成一串发光的字节，
字节沿着导线流向中控面板方块。
中控面板的方块亮起，边框泛起柔和的青色光晕。
仪表方块同步亮起，屏幕上的指针平滑地抬起来。
中控方块旁边另有一个小小的卫星天线图标亮起，
一道淡蓝色的信号锥形波纹从它向外扩散，持续稳定地闪动——
表示 GPS 已经常开。

【镜头 12 · 成果】实拍收尾。电动车停在原地，
仪表屏上电量数字清晰可见，屏幕下方滚动着里程数字。
切到手机屏幕，同一块抽象地图上，一个发光的定位光点正沿着道路
拖出一条连续不断的轨迹线，光点持续在轨迹末端闪烁。
镜头缓慢从手机拉开，越过车把，落在停车的地面上，
晨光从侧面打进来，画面温暖，安静收束。

【贯穿细节】所有镜头中，导线和接插件都符合真实电动车线束的工艺：
波纹管包裹、热缩管、扎带固定、镀金端子。没有科幻感的发光电路板。
```

---

## 旁白文案（约 280 字，配音用）

> 2024 年前后，运营商开始关闭 2G 网络。
> 这台 2017 年的小牛 U1，车上的中控靠 2G 连着云。
> 退网之后，小牛要求车主更换支持 4G 的新版 V35NB 中控。
>
> 换上以后，问题接踵而来。
>
> 其一是断电。这台车本身没有能工作的 485 电机控制器，
> 而新的中控一上电，第一个动作就是向电机控制器索要轮速。
> 问不到，就判定车辆一直静止，五分钟后整车断电。
>
> 其二是 GPS 飘移。定位只在锁车、开锁那一下出现一次，
> 骑在路上全程不定位，所以里程统计一直是空的。
>
> 两个问题其实是同一个根：没有轮速。
> 中控不知道车在动，就既不敢认定它在行驶，也不会让 GPS 保持开机。
>
> 那就把电机控制器造一个出来。
>
> 用 ESP32、霍尔传感器和 TTL 转 485 模块，
> 插在车上的充电口——那里正好有电，也有 485 插座。
> 先从中控飞一根 485 线到电池，再从电池并一根线到充电口。
> 霍尔传感器测出轮速，ESP32 按小牛的私有协议把速度打包成报文，
> 通过 485 发给中控。中控于是以为电机控制器一切正常。
>
> 轮速一到位，电压电流电量正常显示，GPS 也终于能连续记录，
> 里程一条一条累加出来。
> 一台被时代淘汰的车，被重新接回了网络。

---

## 后期字幕清单（AI 生成后手工加）

> 全部用等宽字体（JetBrains Mono / 思源黑体 Mono），青色 `#00E5FF`，描边或半透明黑底。
> 位置统一在画面下三分之一，不要挡住实物。红色 `#FF5252` 用于故障段。

| 时间点 | 字幕内容 | 出现方式 |
|---|---|---|
| 0:04 | `2024 · 2G 退网` | 淡入，配基站波纹消散 |
| 0:09 | `小牛要求更换 4G 版 V35NB 中控` | 淡入 |
| 0:18 | `485 总线 · 9600 8E1` | 淡入，随拓扑动画出现 |
| 0:20 | `仪表 0x10 / 0xEF` | 指向仪表方块 |
| 0:22 | `中控 ECU 0x40 / 0xBF` | 指向中心方块 |
| 0:24 | `FOC 电机控制器 0x20 / 0xDF` | 指向控制器方块 |
| 0:26 | `电池 BMS 0x31 / 0xCE` | 指向电池方块 |
| 0:30 | `68 [地址对] 68 [功能码] [长度] [数据+0x33] [校验和] 16` | 单行等宽，逐段高亮 |
| 0:33 | `校验和 = 累加 & 0xFF` | 追加一行 |
| 0:40 | `新中控上电即查询 FOC 轮速` | 淡入 |
| 0:42 | `无响应 → 判定停车超时 → 5 分钟后整车断电` | **红色**，醒目 |
| 0:47 | `GPS 仅锁车/开锁时定位一次` | 淡入 |
| 0:50 | `骑行途中不定位 → 里程统计为空` | **红色**，追加一行 |
| 0:56 | `根因：没有轮速` | 居中大字，白色 |
| 1:04 | `① 中控 ──485── 电池` | 箭头动画标注飞线 |
| 1:10 | `② 并线 ──485── 充电口插座` | 箭头动画标注 |
| 1:18 | `③ ESP32-C3 + 霍尔 + TTL-485` | 指向充电口转接板 |
| 1:24 | `霍尔 GPIO3 · INPUT_PULLUP · 下降沿中断` | 指向传感器 |
| 1:28 | `6 极磁钢盘 · 轮周长 1.35m` | 指向轮辋 |
| 1:34 | `485 TX=GPIO7  RX=GPIO4 · 9600 8E1` | 指向 ESP32 |
| 1:38 | `轮速 → ECU 判定行驶中 → GPS 常开` | 淡入，指向中控方块 |
| 1:42 | `电量显示 / 里程统计 / GPS 连续记录` | 三个图标依次点亮 |

---

## 生成参数建议

| 工具 | 设置 |
|---|---|
| **Sora / Veo 3** | 16:9，1080p 或 4K，每段 6-8 秒，共约 13-15 段 |
| **Kling 1.6 / 2.0** | "Professional" 模式，Quality High，时长 10 秒，关闭"运动增强" |
| **Runway Gen-4** | 16:9，5 秒/段，Turbo 模式 |
| 通用负面提示 | `字幕, 文字, 水印, logo, 乱码字符, 变形的手, 多余的线缆, 低分辨率, 过曝` |

**剪辑建议**：分镜之间用 0.3 秒交叉溶解；叠加一层极淡的网格/示波器纹理（10% 不透明度）
统一风格；配一段低频的电子氛围音 + 每次数据流动时的轻微"嗒"声；
镜头 1 的信号波纹消散处加一个低沉的"断线"音效。

---

## 如果要更短（30 秒社媒版）

只保留镜头 1（2G 退网）、2（换中控）、4（拓扑）、6（断电）、7（GPS）、9（充电口）、12（成果），
旁白压到 110 字，字幕只留 10 条。

---

## 素材清单（实拍优先，AI 生成兜底）

| 镜头 | 最好用 | 实在没有就 AI 生成 |
|---|---|---|
| 1 | 手机拍一段基站/信号格 | 抽象波纹消散 |
| 2 | 仪表屏实拍信号格消失 | 抽象打叉图标 |
| 3 | 换中控实拍（最好有） | 手部动作特写 |
| 6 | **实拍：拧转把 → 断电**（最有说服力） | 骑行后仪表熄灭 |
| 7 | App 实拍锁车时定位一次 | 手机屏幕抽象光点 |
| 8 | **实拍：飞线拧端子** | 手部动作特写 |
| 9 | **实拍：插充电口** | 手部动作特写 |
| 10 | 实拍磁钢盘转动 | 车轮特写 |
| 12 | App 实拍里程轨迹 | 抽象轨迹线 |

> 实拍素材的优先级高于 AI 生成。涉及"断电""飞线""插充电口"这些关键步骤，
> AI 生成的画面会显得轻飘，观众一眼看得出是假的。
