MrWANGXUHUI/niu-u1-foc-simulator/diagrams/2026-10-22T204500/diagram.png

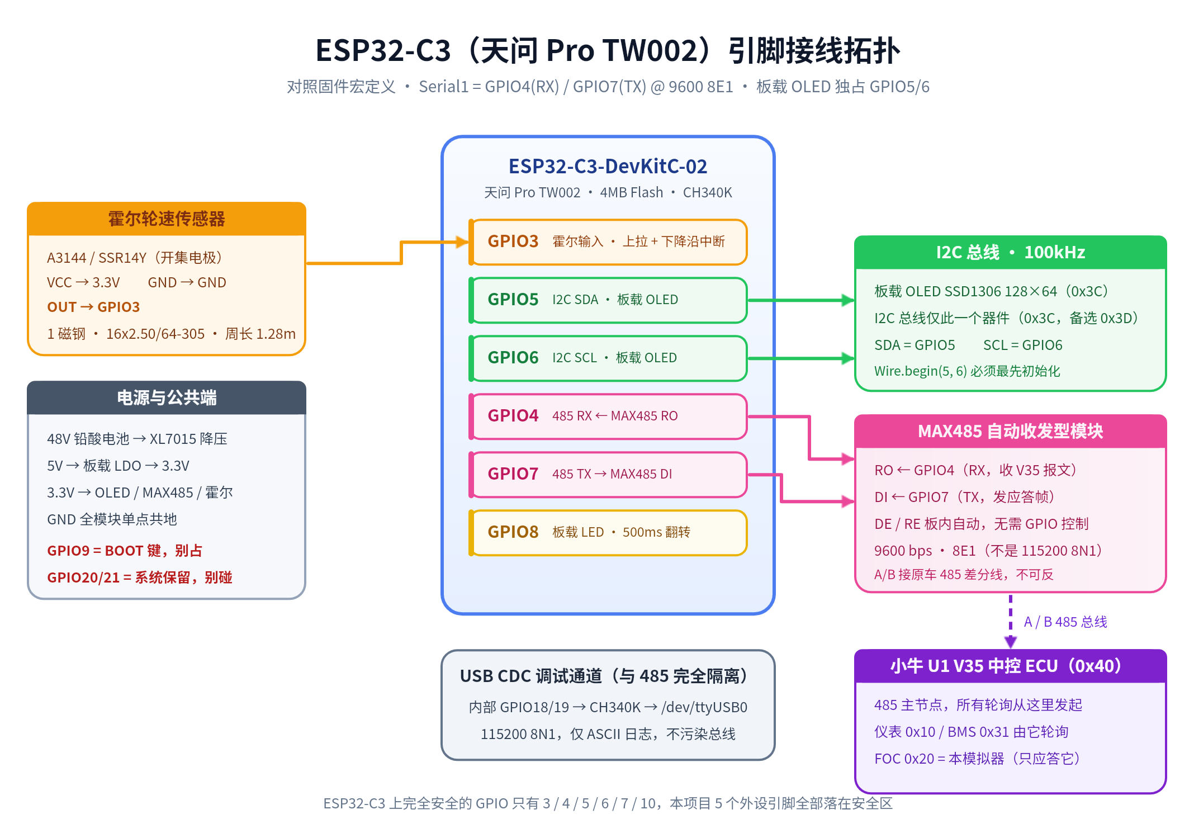
diagrams/2026-10-22T204500/diagram.png
