MrWANGXUHUI/niu-u1-foc-simulator/(commit log)

2026-10-22 小牛 U1 FOC 模拟器：ESP32-C3 替代原厂 FOC 控制器
    用 ESP32-C3-DevKitC-02（天问 Pro TW002）在 485 总线上应答 V35 中控轮询，
    让中控 / 仪表 / 电池认为 FOC 工作正常。
    - 485 协议：9600 8E1，sum&0xFF 校验和，数据区 ±0x33 混淆
    - 应答帧带「回话设备自己」的地址对 0x20/0xDF，与真车抓包一致
    - 状态帧按原厂布局：0x02 05 08 → 12 字节（车速在第 9 字节），05 09 → 14 字节
    - 模拟原厂身份：MU 编号 MU00001B00000001、版本串 U1E02V11U1E02V11
    - 霍尔轮速：GPIO3 INPUT_PULLUP + 下降沿中断，1 磁钢 / 16x2.50/64-305（周长 1.28m）
    - OLED（板载 SSD1306）显示车速，USB CDC 调试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
2026-10-22 加 GitHub API 推送脚本
    这台机器直连 github.com 会 SSL 超时，git push 用不了；Git Data API 走
    api.github.com 可以正常用。脚本保证 blob/tree/commit SHA 与本地一致，
    推送后本地和远端不会分叉。
2026-10-23 霍尔实测轮速 + 修正车速协议刻度
    - USE_HALL_SPEED 置 1, 轮速改由霍尔脉冲间隔实测 (单磁钢下计数窗口会乱跳),
    2s 无新脉冲判停转
    - 车速协议值改为线性刻度 round(kmh*25/12) (0..127), 原来的非线性表封顶 31
    (14.9 km/h) 是把低速段采样误当成整张表
    - README / NOTES / DEVELOPMENT / docs 与飞书接线文档同步更新
2026-10-23 协议车速值改用浮点车速计算, 避免截断丢分辨率
    16.8 km/h 原来先截断成 16 再换算, 协议值少 2 格 (约 1 km/h)。
2026-10-28 ESP32 侧: OTA 服务端 + BLE 遥测 + BMS 解析, 并修掉偶发没有车速
    分区表改 A/B 双槽 (每槽 1.75MB), 才有 OTA 目标分区。
    新增 OTA HTTP 服务 (SoftAP 直传)、BLE 遥测、BMS 报文解析。
    偶发没有车速的三个原因:
    - 车速用最近一次脉冲间隔算, 漏计/噪声脉冲会直接把车速打飞,
    改成取最近 5 个间隔的中位数, 3 秒无脉冲判停转;
    - 485 应答路径上有阻塞式 Serial.flush(), USB 接着但没人读时
    最长阻塞 100ms, 远超 V35 单次轮询 ~20ms 的超时, 改成不阻塞;
    - 收到校验和不对的帧也照样应答, 现在先校验再处理。
    同时加诊断计数 (V35 轮询/应答/霍尔脉冲/校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
2026-10-28 微信小程序: OTA 推固件 + 实时看板, 配套构建/上传脚本
    车停楼下、板上没网, 改固件不能再靠拆线按 BOOT。
    小程序连 ESP32 的 SoftAP, 走局域网直传把新固件推进去
    (微信小程序的局域网例外允许 ${IP}:${PORT} 的 http 请求,
    所以不用备案域名/证书/云开发, 设备也不需要公网出口)。
    同时小程序还当骑车时的实时看板: BLE 读车速/电池/485 诊断,
    OTA 走 WiFi 会断网, 所以遥测另开 BLE 通道, 手机照常上网。
    固件本体不入库: build_ota.sh 编译后 LZ77 压缩再 base64,
    塞进 miniprogram/firmware/firmware.js (小程序主包 2MB 上限)。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
2026-10-29 OLED 画屏挪到独立任务, 修掉 WiFi 连不上 + 屏幕闪烁
    一屏 1024 字节在 I2C 100kHz 下要 95ms, 画屏一直放在 loop() 里,
    loop 有 95% 的时间在画屏, 连带把 485 应答和 WebServer 一起饿死:
    V35 单次轮询超时只有 ~20ms -> 错误码 190 + 车速 0 + 屏幕内容来回变;
    手机连上热点却发不出请求 -> "wifi 连不上".
    - 画屏挪到独立 FreeRTOS 任务 (优先级 1), loop 只写快照
    - I2C 提到 400kHz, 并用 U8X8_DO_NOT_SET_WIRE_CLOCK 挡住 u8g2 改回 100kHz
    - 热点信道 1 -> 11 (默认信道压在 BLE 广播信道 37 上, 共存时连不上)
    - WiFi 发射功率 19.5 -> 8.5dBm, setSleep(false) (防棕断导致反复重启)
    - 屏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
2026-10-29 文档: 刷机不用手动按 BOOT 了 (esptool DTR/RTS 自动进下载模式)
    2026-10-29 连刷三次都是一次成功, 之前记的"CH340K 没接 BOOT, 必须手动按"已经不成立.
    自动复位失灵时的手动流程保留作备用.
2026-10-29 BLE 改名 NIU-U1-BLE, 并把蓝牙错误提示翻译成可操作的步骤
    原来 BLE 设备名跟 WiFi 热点同名 (NIU-U1-OTA), 在手机蓝牙列表里分不清,
    改成 NIU-U1-BLE (小程序只按前缀 NIU-U1 匹配, 不受影响).
    小程序侧:
    - errMsg 翻译: 权限被拒/蓝牙没开/超时/已被占用 各给一条能动手解决的提示
    - 扫不到设备时把实际扫到的名字列出来 —— 一眼区分"权限没给"和"名字不对"
    - 扫描超时 6s -> 8s (iOS 第一次扫比较慢)
    台架实测 (Linux bluetoothctl): 广播名 NIU-U1-BLE, 4 个特征全在, 连接成功, RSSI -46dBm.
2026-10-29 BLE 广播: 名字放主广播包, 修 iPhone 被动扫描看不到设备
    默认 adv 布局把名字+UUID 全塞扫描回应, iPhone 后台小程序被动扫描
    收不到扫描回应, 设备就成了"没名字"被过滤掉。改成自定义广播包放名字,
    扫描回应只留 flags+名字; 小程序扫描窗口加长到 10s, interval 拉到 1s。
2026-10-29 版本号 1.3.2 (广播修复版), 已上传小程序平台
2026-10-30 蓝牙优先架构 v1.4.0: WiFi 默认关, 蓝牙遥控开热点
    iPhone 扫不到 NIU-U1-BLE 的根因是广播包布局: 库默认把名字塞扫描回应, 而
    iPhone 后台小程序是被动扫描收不到扫描回应, 设备成了"没名字"被名字过滤掉。
    改成名字放主广播包, 扫描回应放名字+UUID。
    顺带把 WiFi 改成默认关: 平时纯蓝牙, 小程序升级时通过 BLE 命令特征写一个
    字节 'W' 临时开热点, 推完固件重启就回到默认关。手机平时不再因为连热点而断网。
    另外纠正一个错误结论: 之前用 btmon 的计数推断"共存把广播限到 16 秒一次"是
    假象(btmon 抓的是控制器重复过滤后的上报),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
2026-11-01 修 iPhone 扫不到蓝牙: 去掉 services 过滤 + 固件定期重启广播
    iPhone 能看到笔记本的 BLE 却看不到我们, 说明手机侧没问题, 定位出两个 iOS 特有的坑:
    1. 微信小程序在 iOS 上传 services: [] 会被当成"过滤条件存在", 只上报广播里带
    服务 UUID 的设备 —— 我们主广播包只有 Flags+名字(名字必须放主广播包, iPhone
    后台是被动扫描收不到扫描回应), 正好被过滤掉。改成不传 services, 自己在 JS 里筛。
    2. 固件可能进入"活着但不广播"状态: advertising->start() 撞上 GAP 状态机没准备好
    会被静默丢掉, 代码却以为成功了。加了没连手机时每 15 秒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
2026-11-01 修 iPhone 扫不到蓝牙的真正根因: wx.onBluetoothDevicesFound 在旧基础库里不存在
    用户实测报错 "wx.onBluetoothDevicesFound is not a function" —— 这个 API 是基础库
    2.11.0 才加的, 老版微信只有单数的 wx.onBluetoothDeviceFound。扫描回调压根没注册上,
    所以扫是扫了但没人接结果, 永远扫不到设备。之前一直在调固件侧的广播包, 方向偏了。
    修法:
    - discover() 三路兜底: 新版事件 / 旧版单数事件(参数形状不同, 要包一层) /
    每 1.5 秒 getBluetoothDevices 轮询
    - 点连接前先跑 ble.missingApis() 自检, 缺哪些 API 直接列出来, 而不是抛 is not a function
    - onBLECharacteristicVal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
2026-11-01 文档: iPhone 蓝牙已连上, 记录真正根因与排查教训
    - NOTES.md §7.3 改写为「已解决」: 根因是 wx.onBluetoothDevicesFound 在用户手机的
    微信基础库版本里不存在 (2.11.0 才有), 扫描回调压根没注册上 —— 前面几轮改固件
    广播包、改架构都不是卡住的那一环
    - 顺带记下排查中一并修掉的三个真问题 (名字放主广播包 / 不传 services / 定期重启广播)
    - 记下 btmon 计数不可信的坑 (要 hcitool lescan --duplicates)
    - DEVELOPMENT.md 补「排查手机端问题先确认手机端代码真的跑到了」这条教训
2026-11-02 小程序改版(车辆页默认+独立升级页), 并修 /ota/info 一发就重启的 bug
    界面:
    - 拆成两个 tab: 车辆(默认) + 升级
    - 蓝牙连接提到全局单例 utils/bleLink.js, 两个页面共享同一条连接
    - 升级页改成三步引导: 蓝牙开热点 → 手机连热点 → 传固件
    - 通知回调统一在 bleLink 注册一次, 修掉页面来回进出重复注册的老 bug
    修 bug:
    - /ota/info 的 snprintf 参数跟格式串错位一格, %s 吃到整数 1 当指针解引用,
    板子一发请求就 Load access fault 重启. 参数逐个标注对应哪个占位符.
    - ESP.getSketchSize() 会重算 1.5MB 镜像的 SHA256, 换成直接查分区表
    固件:
    - 新增蓝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
2026-11-02 修 wx:else 前面夹注释的隐患, 并加 dump_appjson.js 排查打包产物
    - vehicle.wxml: wx:else 只能紧跟在 wx:if 后面当兄弟节点, 注释挪进 block 里
    - project.config.json: packOptions.ignore 排除 .js.map
    - tools/dump_appjson.js: 本地跑一遍 miniprogram-ci 编译, 打出生成的 app.json
    和文件清单 (上传日志只列 .js/.wxml/.wxss, 看不到它重新生成的 app.json)
2026-11-02 保留旧页面路径做跳板, 修默认入口报"该页面不存在"
    小程序可以带着一个页面路径被打开, 而那个路径可能记在公众平台的「小程序主页」、
    老的小程序码、历史分享链接里 —— 指向改名前的 pages/telemetry/telemetry 或
    pages/index/index. 那个路径不存在的话, 微信直接报 "该页面不存在, 你可以进入
    XXX首页获取更多服务", 用户连小程序都进不去 (但点左上角「首页」是好的,
    因为那个走 pages[0]).
    现在这两个旧路径留着同名空页, 进来就 wx.switchTab 到新页面. tabBar 页面只能
    用 switchTab 跳, redirectTo/navigateTo 跳不过去.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
2026-11-02 文档: 记录"改页面路径要留跳板页"这个坑
2026-11-02 跳板页改跳默认首页(车辆), 修默认打开落在升级页
    旧版 app.json 的 pages[0] 就是 pages/index/index, 所以公众平台记下来的
    「小程序主页」正是这个路径, 默认打开走它. 跳板必须跟新的 pages[0] 保持一致,
    不能跳到升级页.
2026-11-03 修 BMS 应答解析的栈越界 (车上蓝牙连不上/反复重启的疑似真凶)
    bms_protocol.h 解析 BMS 应答时, plain[] 缓冲区是照着目前观测到的最大帧
    (43 字节) 开的, 一个字节余量都没有; 而 dataLen 直接取自总线帧内容, 最大能到
    255, 没有任何上限检查 —— BMS 只要回一帧数据区 > 43 字节的应答, plain[i] 就
    写穿栈, 踩坏相邻的栈数据 → 板子 PANIC 重启.
    表现: 手机蓝牙列表里 NIU-U1-BLE 忽隐忽现, 屏幕黑, 连上约一秒就掉.
    台架接电源时蓝牙正常, 因为台架没接 ECU, 总线上一帧 BMS 都没有, 这段代码
    一次都没跑过; 装车后 ECU/BMS 一开口它才第一次执行.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
2026-11-03 推送脚本改成逐个重放历史, 别再把攒下的提交压扁
    旧版只拿本地 HEAD 建一个 commit, 父提交直接指向远端 —— 本地只比远端多一个提交时
    是对的, 一旦攒了多个 (这次是 17 个), 推上去就等于把它们压成一个, GitHub 上的
    中间历史全没了。
    改成:
    * 从远端那个 commit 往后, 按 git rev-list --reverse 逐个重放
    * 每个提交的 tree / 作者 / 时间 / 说明都取自本地那个 commit, SHA 跟本地一致
    * blob 先 GET 查远端有没有, 没有才上传 (同内容同 SHA, 幂等)
    * tree 也先查远端有没有, 没有才按 ls-tree 全量重建, 并校验 SHA 与本地一致
    * commit SHA 跟本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
2026-11-03 .gitignore 加上 __pycache__/
    推脚本是 python, 一跑就生成 pycache/ 目录, 之前漏了没被忽略。
2026-11-04 固件版本 1.4.2 -> 1.4.3 (修 BMS 栈越界那版)
    版本号通过 /ota/info、OLED 和蓝牙命令 'V' 三处暴露, 小程序拿它跟设备当前版本比,
    版本不变的话小程序不会提示升级, 用户还停在有 bug 的旧固件上。
    已用这一版打包并上传小程序平台 (版本 1.4.3, 描述"修 BMS 应答解析栈越界(车上反复重启)")。
2026-11-04 文档: 记录"车上蓝牙连不上"的根因 (BMS 栈越界) 和教训
    真因已确认: bms_protocol.h 解析 BMS 应答时栈缓冲区越界 → PANIC → 板子反复重启 →
    蓝牙忽隐忽现. 刷 1.4.3 上车验证, 蓝牙恢复正常.
    NOTES.md 补 §7.5 专项 + §7 表格一行, 记的是三件事:
    1. bug 本身 —— plain[43] 照"观测到的最大帧"开, dataLen 无上限检查, 写穿栈
    2. 为什么台架测不出来 —— 台架没接 ECU, 总线上一帧 BMS 都没有, 这段代码一次没跑过
    3. 教训 ——
    * "接了真实总线才会第一次执行"的代码路径, 台架必须用真车抓包喂一遍
    * 按"当前观测到的最大值"开的缓冲区是定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
2026-11-04 修车速离谱: 霍尔毛刺闸门 (固件 1.4.4)
    现象: 真实 20km/h, 小程序显示 800~1000km/h (虚高约 40 倍).
    代码里的公式和常量全是对的 (rpm = 60/(间隔秒数 × MAGNET_COUNT), MAGNET_COUNT=1,
    WHEEL_CIRCUMFERENCE_M=1.28, HALL_HISTORY=5 取中位数). 唯一的漏洞在 ISR 的消抖:
    HALL_DEBOUNCE_US 只有 1ms —— 车上 485 和电机控制器是强干扰源, 传感器开漏输出用
    内部 45k 上拉走长线, 边沿振铃/毛刺完全能穿过去.
    一个毛刺会把一个真间隔劈成"几毫秒 + 剩下的"两半: 短的进中位数历史, 长的比真实值大.
    毛刺占多数时, 5 个样本的中位数直接变成毛刺值 → 转速离谱.
    PC 上仿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
2026-11-05 蓝牙通知搬进独立任务 + 485 总线日志 (固件 1.5.0)
    现象: 手机连上蓝牙后, 小程序上车速正常、485 原始帧也有, 但**电池面板一直是空的**.
    原因不在 BMS 解析 (2041 帧真车抓包验过, 100% 成功), 也不在 BLE 电池消息格式
    (两端打包/解包对得上). 剩下的是**时机**: 蓝牙通知原来是在主循环里直接发的,
    而主循环同时是 485 应答的唯一路径 —— V35 单次轮询的超时只有 ~20ms (抓包量的).
    一次通知突发 (遥测1 + 485帧1~4 + 电池状态1 + 单体2 + 型号1, 最多 8~9 包) 就能把
    应答拖过超时. 遥测是每次突发的**第一个** (总发得出去 → 车速正常), 电池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
2026-11-05 修日志导不出来(GATT handle 不够) + 自适应毛刺闸门 + 电池趋势图 (固件 1.5.1)
    ## 1. "保存 485 日志"一直导出中, 一次都没成功过
    根因不在日志逻辑, 在 BLE 服务本身: Arduino BLE 里**每个特征占 3 个 handle**
    (特征声明 + 值 + CCCD 描述符), 服务默认只给 15 个 (扣掉服务自己的 1 个 = 14 可用).
    原来 4 个特征占 12 个刚好够用; 加到第 5 个 (日志特征) 就要第 15 个 → **越界**,
    esp_ble_gatts_add_char 失败, 特征**根本没建出来**.
    症状特别坑, 因为**前 4 个特征一切正常** (车速、电池都对):
    - 手机订阅不到日志特征 → subscribe() 抛异常被 try/catch 吞了 →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
2026-11-05 记录: 车速跳变已上车验证修好 (固件 1.5.1)
    用户实测确认 1.5.1 的自适应毛刺闸门有效 —— 车速不再跳。
    由此确定跳的是**往上** (多出来的振铃脉冲把间隔压短了), 不是漏脉冲;
    所以没有加"间隔比中位数大很多就丢弃"那条规则 (急刹时容易误杀).
    同时把三条"通用建议"为什么在这套硬件上不成立记进 NOTES:
    - PCNT 硬件计数 + 硬件滤波: 脉冲只有 8.7Hz, 中断一秒才 8.7 次, 不存在"CPU 忙于中断";
    我们的干扰离真沿 3~60ms, 硬件滤波窗口要 ~10ms 才有意义 (建议里的"几微秒"比现有的
    1ms 软件消抖还细, 等于放宽过滤); PCNT 给计数不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
2026-11-08 修: 拉完日志后蓝牙通知全停 + 这台车的 BMS 回 55 字节 (固件 1.5.2)
    用户实测反馈两个问题, 抓的 485 日志 (docs/niu485-20261106-090017.log) 把范围缩死了:
    1. 拉完日志后, 小程序速度固定在 19.6km/h 不动, 电池也没数据
    2. 电池面板一直空着 (没有电量)
    ## 1. 拉完日志后通知再也不发了 (1.5.1 我自己写的 bug)
    日志里固件**活着**: 57 次 V35 轮询 57 次应答, 延迟 1~16ms 全赶得上 20ms 预算.
    但固件报的车速是协议值 5 (2.4km/h), App 显示 19 (协议值 41) → **App 上的数是陈旧的**.
    根因: `serviceNotifications()` 里 `if (pumpLog()) return true;` —— 而 `pumpLog()` 在
    "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
2026-11-09 小程序: 停滞检测 + 日志对账 + 单体柱状图标签宽度 (配合固件 1.5.2)
    用户反馈 1.5.2 之后"速度还是有概率冻结", 以及"单体电压低的串柱子反而高".
    固件这次没动 (1.5.2 的包就是最新的), 改的是小程序和分析脚本.
    ## 1. 别猜, 把两边的值放进同一份日志对账
    * App 侧最后收到的遥测写进导出日志的文件头:
    `# APP 车速 19.6 km/h | 协议车速 41 | 收到于 ...`
    * 固件侧解析出来的车速本来就在日志正文里 (我们回给 V35 的帧里那个车速字节)
    * analyze_485_log.py 多一节「车速对账」, 两边不一致直接点破:
    固件解析值: 57 帧, 协议车速 5 ~ 5 (2.4 km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
2026-11-09 修: 车速冻在 19.6km/h —— 毛刺闸门自锁 (固件 1.5.3)
    19.6 正好是 39.2 的一半, 而这车最高 40km/h. 根因: 1.5.1 的自适应闸门
    (门槛 = 最近一次可信间隔 × 60%) **没有上限**, 猛加速时会自锁:
    1. 19.6km/h 时门槛 141ms; 一脚油门冲到 40km/h, 真间隔掉到 115ms
    2. 115 < 141 → 第一个**真**脉冲被当成毛刺丢掉
    3. 丢毛刺时不更新时间戳 → 下一拍量到的间隔跨了两圈 = 230ms (真值两倍)
    4. 230ms 进历史 → 门槛涨到 138ms → 还是丢 → 死循环
    车速于是永久锁在真实值的一半, 停下再起步才恢复. 这就是"有概率"的由来:
    要冲得够猛才触发.
    修法: 门槛加**上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
2026-11-10 文档: 加小程序车辆页截图 (docs/mini_prog.jpg)
    README.md §"小程序长什么样" 和 DEVELOPMENT.md §9 各插一张实拍图,
    并逐条说明截图里能看到什么 (车速 / 电池区 / BMS 应答诊断 / 两条趋势曲线 /
    13 串单体电压柱状图).
    顺带把仓库结构那棵树补全: docs/ 下多了 mini_prog.jpg 和 niu485-*.log,
    固件 src/ 下多了 hall_speed.h (上一条提交加的测速头文件).
2026-11-10 修: 刚骑车车速飙到 100+km/h —— 没有参照量时门槛太松 (固件 1.5.4)
    用户反馈"刚骑车是一百多的速度, 好像是十倍, 骑一会速度就正常了".
    "十倍"是关键线索: 1.28m 的轮子, 间隔短 10 倍 = 车速高 10 倍.
    根因: 1.5.1~1.5.3 的闸门是 clamp(参照量×60%, 25ms, 80ms), 但**参照量=0 时**
    (刚开机 / 刚停车超 3 秒 → 历史清空 → 参照量清零) 门槛只剩 25ms 下限, 太松:
    1. 车上振铃是"离真沿 3~60ms"
    2. 起步没有参照量 → 门槛 25ms → 26~60ms 的振铃被当成真脉冲收下
    3. 那个 30ms 的间隔进历史 → 中位数被污染 → 车速 = 1.28/0.030 = 153km/h
    4. 污染还自持: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
2026-11-11 修: 车速下面那排的电压/电流是死的 —— 删掉重复项, 改成 BMS 真值 (固件 1.5.5)
    用户反馈"速度下面的电压和电流现在是死的吧? 电流也一直是 0,
    如果和 bms 重复了就删除吧". 查下来确实是**两处假数**:
    车速下面那排 "电压/电流" → foc_status.voltage/.current, 初值写死 480/0,
    从来没人改过 → 永远显示 48.0V / 0.0A
    电池区 "总电压/电流" → BMS 报文真值 → 45.2V / 真电流
    不但重复, 还**打架** (48.0V vs 45.2V).
    1. 小程序: 车速下面那排删掉 "电压" "电流" 两格, 只留 转速 + 锁定状态.
    电池区的 BMS 真值保留 (那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
